Thompson-Junyang/ucf-hand-design-project/README.md

# UCF Robotic Hand Design Project

Written by Junyang. 

I created this repository as an **organized copy of the original ORCA Hand design files** for the UCF robotic hand project. So far, I have collected, reviewed, and sorted the files into a more convenient structure. **I have not yet redesigned the hardware.**

My next major objective is to **replace the original ORCA Hand actuators with Dynamixel AX-18A servos**. The AX-18A conversion is **planned, not implemented yet**; the current models should not be assumed to fit AX-18A motors.

## Official ORCA Hand resources

- **Official website:** [ORCA Hand](https://www.orcahand.com/)
- **Fabrication and assembly tutorial:** [ORCA Hand full fabrication and assembly tutorial](https://youtu.be/TgIz7HiyaoU?si=PWOCt1g08h2LHRF3)

## Where to start

1. Open [`all files we corrently need/orca_v2/base_basic v2 version start with this folder/`](all%20files%20we%20corrently%20need/orca_v2/base_basic%20v2%20version%20start%20with%20this%20folder/).
2. Start with `Prints-1100_the hand 3d designed files.3mf` for the hand print plates and `SiliconeMolds-1100_the mold 3d file for silicon skin.3mf` for the silicone-skin molds.
3. For individual STL and STEP components, open `full v2 hand files/` inside the same directory.
4. Read `full v2 hand files/ASSEMBLY_ADDENDUM.md` alongside the [ORCA Hand fabrication and assembly tutorial](https://youtu.be/TgIz7HiyaoU?si=PWOCt1g08h2LHRF3). The addendum includes important corrections about PTFE tubes, thumb pins, carpal bearings, and spools. I have already organized the project BOM; see the final section for my completed reference workbook.
5. Treat the `touch` and `lite` directories as alternative designs, not as required components of the base build.

> **Important:** The current files include original Dynamixel and Feetech-specific parts. A filename containing `Dynamixel` does **not** establish compatibility with the AX-18A. Check dimensions, horn interface, fasteners, cable routing, torque, and power requirements before fabrication.

## Repository directory guide

The directory names below are reproduced **exactly as stored in this repository**, including their existing spelling, to make them easy to find.

### 1. `all files we corrently need/` — selected working files

This is the **working collection I selected and organized** for the project, containing the ORCA V2 designs I plan to study and modify.

- **`orca_v2/`** — selected V2 mechanical and electronic design files.
  - **`base_basic v2 version start with this folder/`** — **primary starting point** for the standard V2 hand. Contains two conveniently named `.3mf` print projects and the more complete `full v2 hand files/` directory.
    - **`full v2 hand files/`** — complete base-V2 hand component collection, including `Prints-1100.3mf`, `SiliconeMolds-1100.3mf`, left/right ZIP archives, assembly notes, and the folders below:
      - **`01_Fingers/`** — printable finger segments and thumb components (`.stl`); `step_files/` contains corresponding editable/importable CAD exchange models (`.step`).
      - **`02_Carpals/`** — palm/carpal structures, cores, gearing, and TPU carpal-skin components; `step_files/` contains available STEP models.
      - **`03_Wrist/`** — wrist structures, adapters, cable holders, and wrist gear, including separate original **Dynamixel** and **Feetech** configurations; `step_files/` contains STEP counterparts. **Relevant to the future AX-18A fit check.**
      - **`04_ForeArm/`** — forearm/tower structures, front/back shells, covers, fans, and mounting-related parts, with original motor-system-specific variants; `step_files/` contains available STEP models. **Likely a major AX-18A redesign area.**
      - **`05_Spools/`** — tendon-winding spool, ratchet, spool cover, and tensioner components, with STEP counterparts in `step_files/`. **Check mechanical coupling to replacement servos.**
      - **`06_CNC/`** — manufacturing models and PDF technical drawings for machined components, including the spool holder and Franka connector.
      - **`07_Molds/`** — mold STLs and `.3mf` projects for silicone skins, including compression molds and clips.
      - **`09_Skin/`** — finger and carpal skin STL geometry for flexible covers.
      - **`assembly-addendum/`** — photographs and diagrams referenced by `ASSEMBLY_ADDENDUM.md` (PTFE routing, bearings, pins, spool identification, and assembly tips).
      - **`ASSEMBLY_ADDENDUM.md`** — text instructions supplementing the original assembly video; review before assembly.
  - **`electronics_pcb files and random/`** — original ORCA motor-connector PCB documentation: `ORCA_Motor_Connectors_BOM.xls` and `ORCA_Motor_Connectors_Gerber/`.
    - **`ORCA_Motor_Connectors_Gerber/`** — PCB fabrication layers, drill files, and `How-to-order-PCB.txt`. **Connector compatibility must be rechecked for AX-18A.**
  - **`lite_a simple verson of v2 we dont need/`** — lightweight/simplified V2 variant files (`.stl`/`.step`). Retained for reference; **not the current build target**.
  - **`touch_the version that allows us to add touch sensor/`** — alternative V2 design intended to accommodate fingertip touch sensors. Contains `Prints-2100.3mf`, `SiliconeMolds-2100.3mf`, and left/right ZIP archives.
    - **`01_Fingers/`** — touch-variant finger STL parts; `step_files/` contains available STEP models.
    - **`02_Carpals/`** — touch-variant carpal STL parts; `step_files/` contains STEP models.
    - **`09_OldPrintBeds/`** — earlier touch-variant `.3mf` print-bed projects; use the main `Prints-2100.3mf` as the current touch starting point instead.

### 2. `full files check it out if have time/` — complete upstream reference archive

I kept this folder as a broader archive of original ORCA project material. It is **reference material**, not my preferred starting point for the UCF build.

- **`README.md`** — upstream ORCA file-set overview, including variants, print projects, and scripts.
- **`assets/`** — upstream documentation image assets (including `banner.png`).
- **`orca_v1/`** — older ORCA Hand V1 design, useful for historical comparison:
  - **`ORCA_Assembly/`** — V1 assembly STEP model.
  - **`ORCA_Electronics/`** — V1 motor-connector BOM and `ORCA_Motor_Connectors_Gerber/` fabrication files.
  - **`ORCA_Fingers/`** — V1 finger geometry.
  - **`ORCA_Misc/`** — miscellaneous parts, including a camera mount.
  - **`ORCA_Molds/`** — V1 finger and palm skin mold models.
  - **`ORCA_Spools/`** — V1 tendon spool, ratchet, holder, and tensioning components.
  - **`ORCA_Tower/`** — V1 tower/actuator mounting, gearing, carpal, and support parts.
  - **`Print_Files_Bambu/`** — V1 Bambu Studio `.3mf` print projects for fingers, wrist, molds, spools, and tower.
- **`orca_v2/`** — original V2 source collection:
  - **`base/`** — original base V2 hand: the same component categories as the selected `full v2 hand files/` directory (`01_Fingers`, `02_Carpals`, `03_Wrist`, `04_ForeArm`, `05_Spools`, `06_CNC`, `07_Molds`, `09_Skin`, and `assembly-addendum`), plus base print projects, ZIP archives, and `ASSEMBLY_ADDENDUM.md`.
  - **`electronics/`** — original motor-connector BOM and `ORCA_Motor_Connectors_Gerber/` PCB fabrication files.
  - **`lite/`** — original simplified V2 part collection.
  - **`touch/`** — original touch-sensor V2 variant, including `01_Fingers/`, `02_Carpals/`, `09_OldPrintBeds/`, touch print/mold `.3mf` projects, and ZIP archives.
- **`scripts/`** — upstream Python utilities for managing `.3mf` projects:
  - `find_3mf_for_file.py` — identify which print projects contain a particular STL.
  - `update_3mf.py` — update or inspect STL references inside a `.3mf` project.
  - `update-print-files.py` — automate print-project updates from changed files.
  - `dedup_3mf.py` and `dedup_3mf_build_items.py` — utilities related to removing duplicate `.3mf` data/build items.
- **`package.json` / `package-lock.json`** — upstream package metadata and dependency lockfile; not necessary merely to open STL/STEP/3MF files.

## File formats

| Format | Purpose |
|---|---|
| `.3mf` | Pre-arranged 3D printing projects; open in a compatible slicer such as Bambu Studio. |
| `.stl` | Mesh geometry for printing and inspection. |
| `.step` | CAD exchange geometry useful for modifying mechanical designs. |
| `.zip` | Packaged original design files. |
| `.pdf` | Technical drawings and manufacturing documentation. |
| `.xls` | Original motor-connector PCB bill of materials. |
| Gerber / `.DRL` | PCB fabrication layers and drill data. |
| `.md` | Markdown documentation. |

## Planned development: Dynamixel AX-18A conversion

**Status: not started / not yet implemented in the stored design files.** My planned engineering sequence is:

1. **Document the baseline:** identify the original motor models, number of actuators, mounting points, tendon routing, and electrical interfaces.
2. **Check AX-18A mechanical compatibility:** body envelope, horn/output geometry, mounting-hole spacing, clearances, and service access.
3. **Redesign mounts and support structures:** prioritize the forearm/tower, wrist interface, and any actuator brackets that require modification.
4. **Review tendon transmission:** check spool geometry, horn coupling, cable travel, winding direction, friction, and tensioning.
5. **Review electrical and control interfaces:** verify power distribution, connectors, communication protocol, controller support, and actuator limits.
6. **Produce revised CAD and print files:** maintain a separate AX-18A design revision rather than overwriting original ORCA reference models.
7. **Prototype, assemble, and validate:** check mechanical fit, range of motion, tendon tension, repeatability, and thermal/electrical behavior.

Do not print or purchase AX-18A-specific hardware based solely on the current original motor-holder files; the conversion needs its own validated design.

## Fabrication Process

This section records my fabrication progress for the ORCA Hand V2 build. I will update each stage as the work progresses.

### 1. 3D Printing — Tested Print Project

**Status as of October 23, 2026: Print settings tested and stable.**

I am currently printing the latest **ORCA Hand V2 V1100** version. The `.3mf` project files I uploaded to this repository are **my optimized printing projects**, rather than unmodified upstream print settings. I prepared and tested these projects for the **Bambu X2D** printer.

- **Design revision:** ORCA Hand V2, V1100.
- **Printer:** Bambu X2D.
- **Primary printing material:** PLA.
- **Support material:** PETG (support interface/material).
- **Print profile:** My tested and stable parameter configuration, saved in the uploaded `.3mf` projects.
- **Working project files:** `all files we corrently need/orca_v2/base_basic v2 version start with this folder/`, including `Prints-1100_the hand 3d designed files.3mf` and `SiliconeMolds-1100_the mold 3d file for silicon skin.3mf`.

The uploaded `.3mf` files should be used when reproducing my tested print setup. The print profile has been tested for stability.

#### 3D Printing Examples

The following images document my actual V1100 printing process using the tested `.3mf` projects. They show the different groups of components being printed, including the silicone-skin molds.

**1. Finger components — printing process**

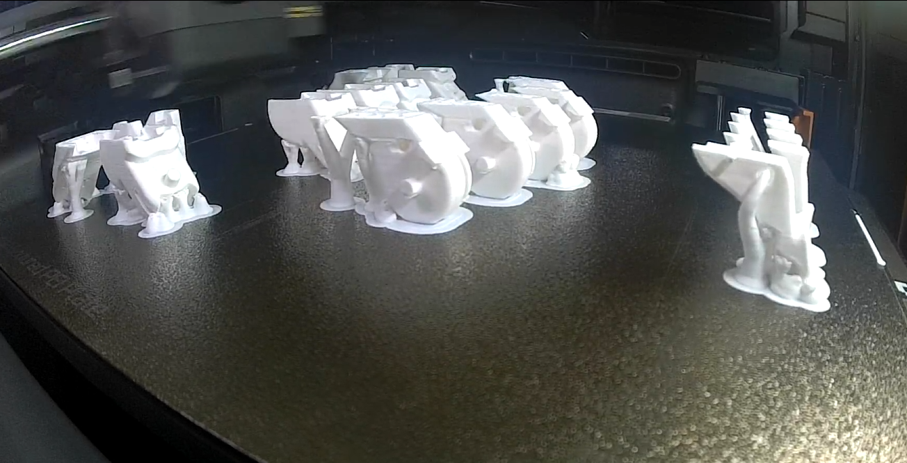
[picture p1: fabrication_images/01_finger_printing.png]
ORCA Hand V1100 finger components being printed


**2. Wrist components — printing process**

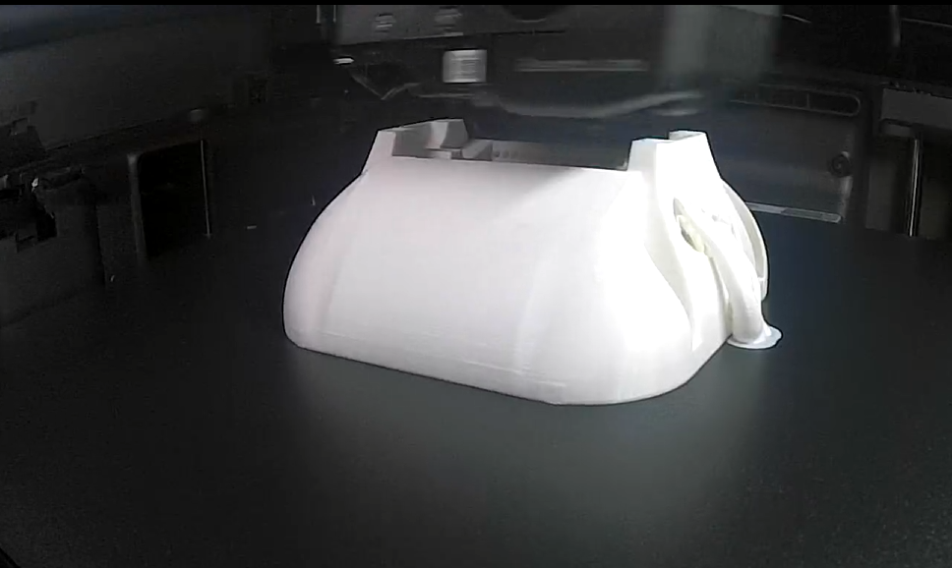
[picture p2: fabrication_images/02_wrist_printing.png]
ORCA Hand V1100 wrist component being printed


**3. Forearm structure and motor-mount section — printing process**

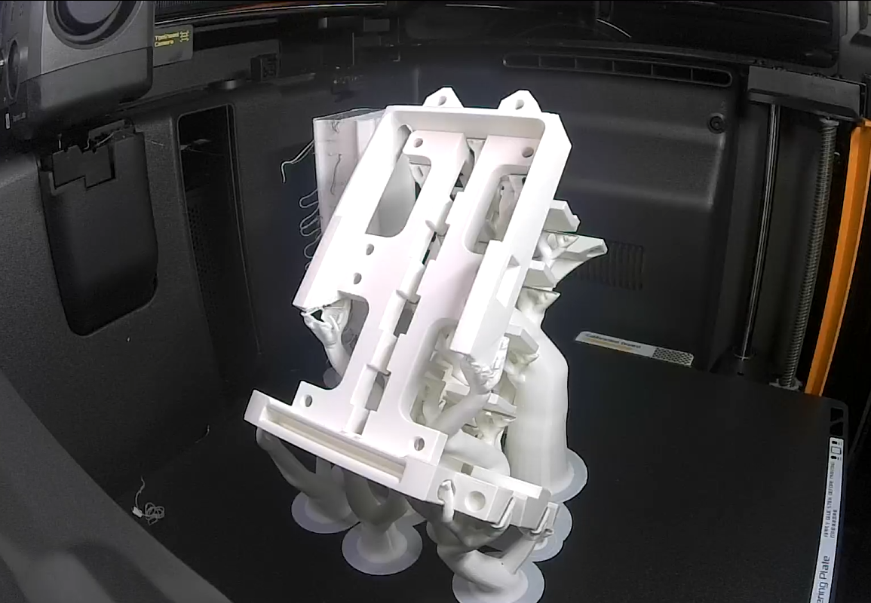
[picture p3: fabrication_images/03_forearm_motor_mount_printing.png]
ORCA Hand V1100 forearm structure including the original motor-mount section being printed


**4. Silicone-skin molds — 3D printing process**

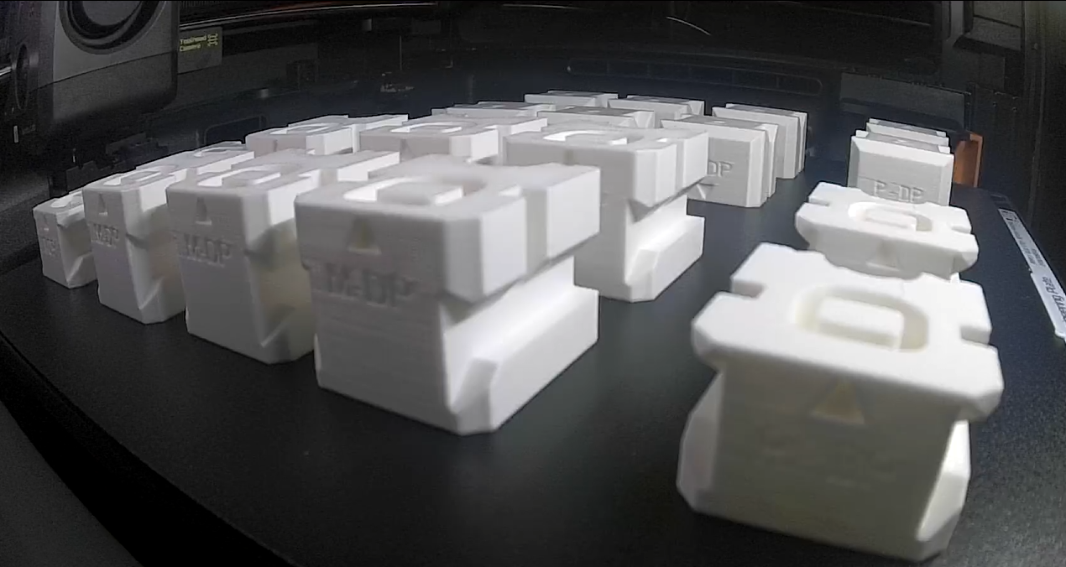
[picture p4: fabrication_images/04_silicone_skin_mold_printing.png]
ORCA Hand V1100 silicone-skin molds being printed


These images document 3D printing only. Printing the silicone molds does not mean silicone casting has been completed, and printing the original motor-mount structure does not mean the planned AX-18A modification has been implemented.

### November 2, 2026 — Multi-Material Support Printing (PLA/PETG)

**Status: Support-interface printing method researched and applied to ORCA Hand V1100 slicing layouts.**

I investigated using **PLA and PETG as dissimilar support materials** to improve the surface finish of supported regions in FDM printing. PLA and PETG generally adhere poorly to each other under suitable printing conditions. This makes it possible to use **PLA as the support interface for PETG parts**, or **PETG as the support interface for PLA parts**, so the support can separate more easily from the printed model.

In conventional same-material supports, a gap is often required between the support and the model to allow removal, which can leave rough undersides. With a properly tuned dissimilar-material interface, the support can be placed closer to the model, potentially producing **smoother supported surfaces and cleaner overhangs** while reducing support-removal damage. This is especially useful for the complex geometries and overhangs in the ORCA Hand parts. Print temperature, purge/flush volume, interface spacing, and material compatibility still require appropriate slicer settings and validation.

#### Reference Examples — Multi-Material Support Method

The first four images are explanatory references attributed to Bambu Lab and Prusa, illustrating dissimilar-material support and the distinction between the support base and the support interface. They are **reference illustrations, not photographs of my own prints**.

**1. Surface-finish comparison — PETG with PLA support vs. PETG support**

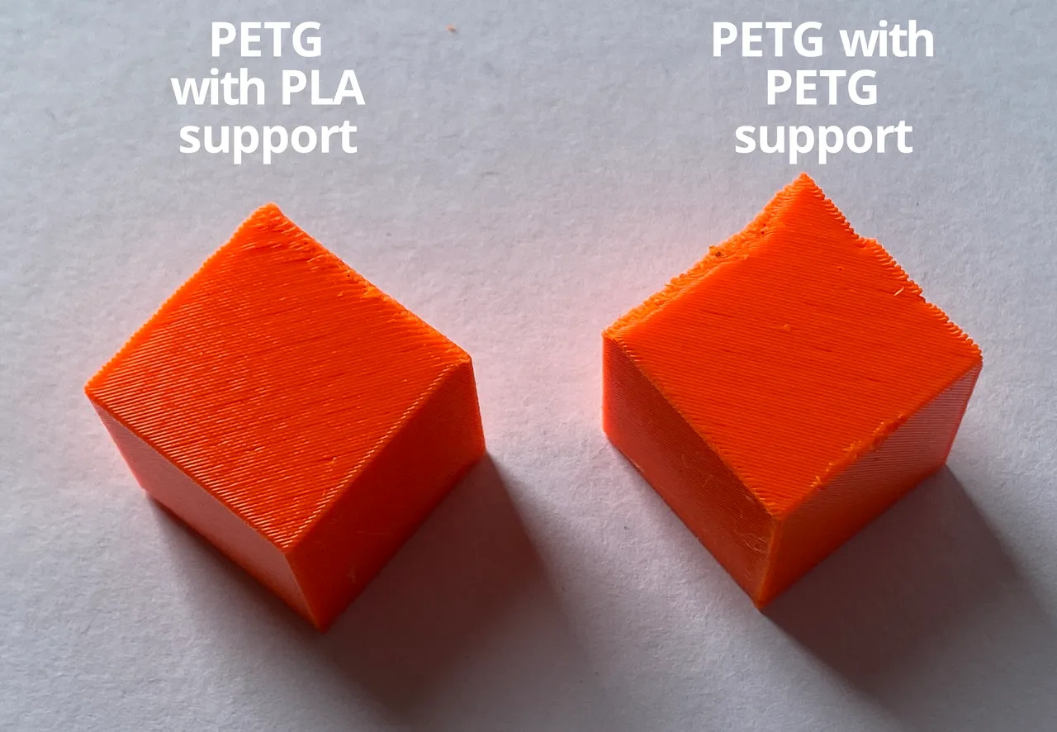
[picture p5: fabrication_images/11_support_reference_surface_comparison.png]
Reference comparison of PETG printed with PLA support and PETG support


**2. Material arrangement — PLA model and PETG support interface**

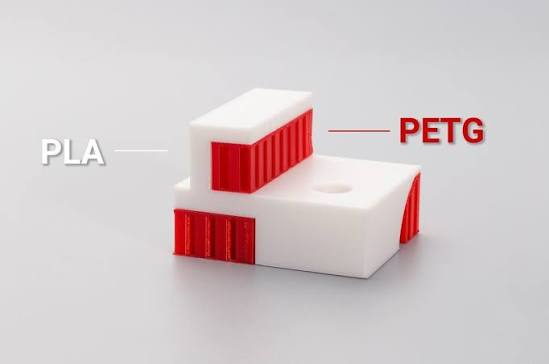
[picture p6: fabrication_images/12_support_reference_material_arrangement.png]
Reference diagram illustrating PLA and PETG support materials


**3. Support-removal example — dissimilar-material and same-material supports**

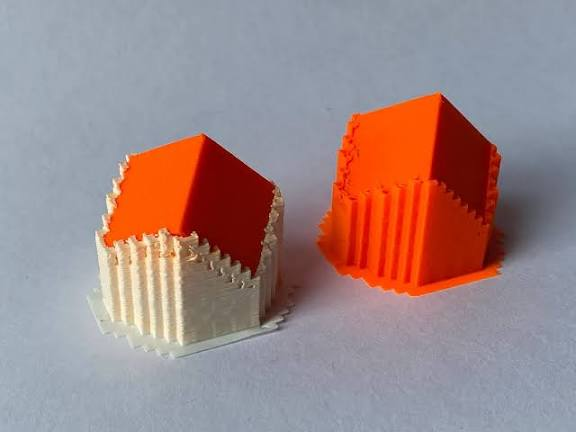
[picture p7: fabrication_images/13_support_reference_removal_comparison.png]
Reference example comparing support removal


**4. Support interface versus support base**

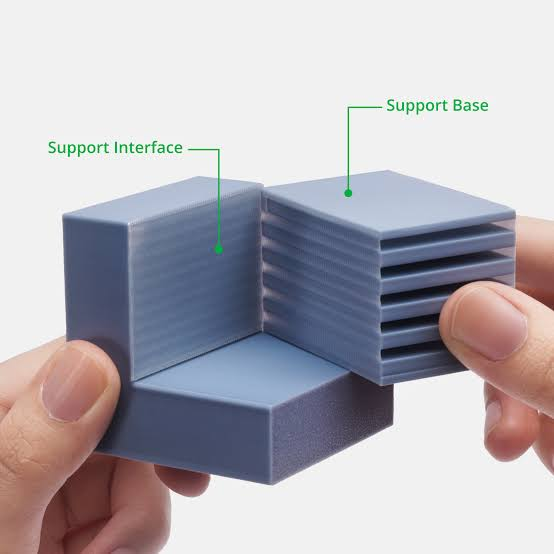
[picture p8: fabrication_images/14_support_reference_interface_base.png]
Reference illustration labeling support interface and support base


#### Application to the ORCA Hand V1100 Print Project

I applied the dissimilar-material support approach to the ORCA Hand print layout in the slicer. The following screenshots show the hand components, their complex overhangs, and the configured support structures. These screenshots document the **slicing setup and implementation**, rather than a measured comparison of finished printed surfaces.

**5. ORCA Hand slicing layout — multi-material support configuration (view 1)**

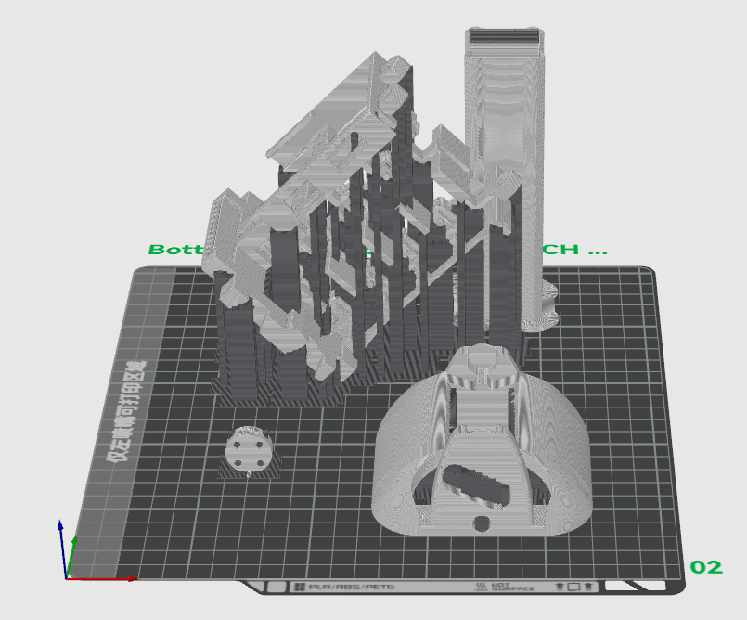
[picture p9: fabrication_images/15_orca_multimaterial_support_slicer_view1.png]
ORCA Hand V1100 slicing layout with support structures, view 1


**6. ORCA Hand slicing layout — multi-material support configuration (view 2)**

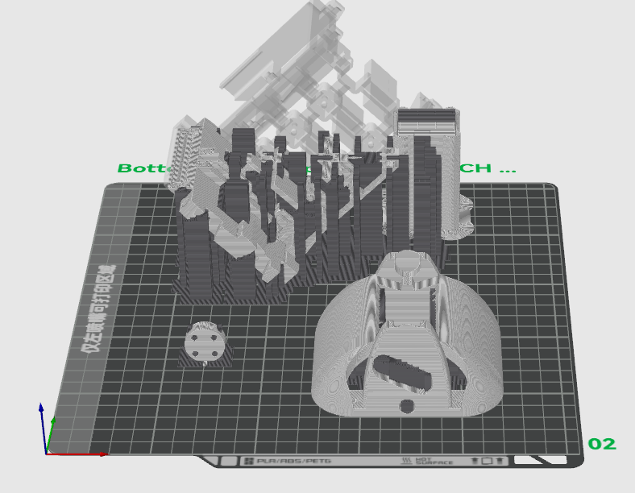
[picture p10: fabrication_images/16_orca_multimaterial_support_slicer_view2.png]
ORCA Hand V1100 slicing layout with support structures, view 2


**Next verification:** Print and inspect the supported surfaces on the actual ORCA Hand parts to compare removal quality and surface finish with the previous support setup.

### 2. Silicone Molding — Initial Casting and Demolding

**Status as of October 23, 2026: Initial silicone molding and demolding completed; process documentation ongoing.**

I have started fabricating the silicone skins using the 3D-printed V1100 molds. The photos below document my initial casting, demolding, and organization work. I used a two-part silicone system (Parts A and B 1: 1). The curing condition is room temp over 10 hours.

#### Silicone Molding Examples

**1. Silicone casting — mold filling process**

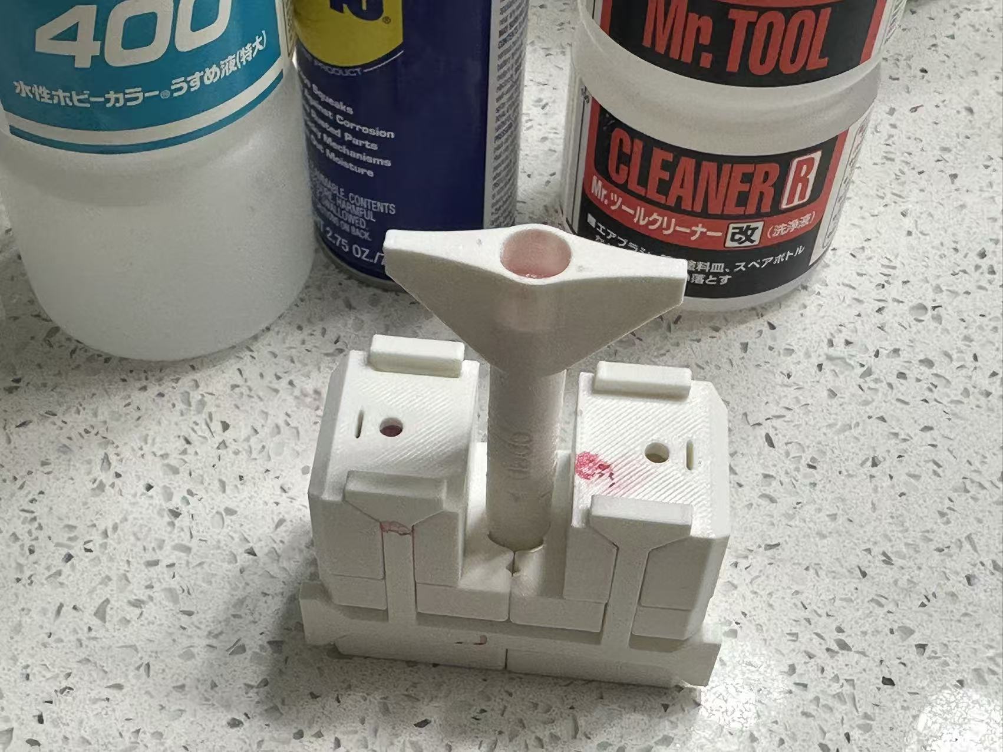
[picture p11: fabrication_images/05_silicone_casting.jpg]
Silicone being cast into a 3D-printed mold


**2. Demolding — removing the silicone skin from the mold**

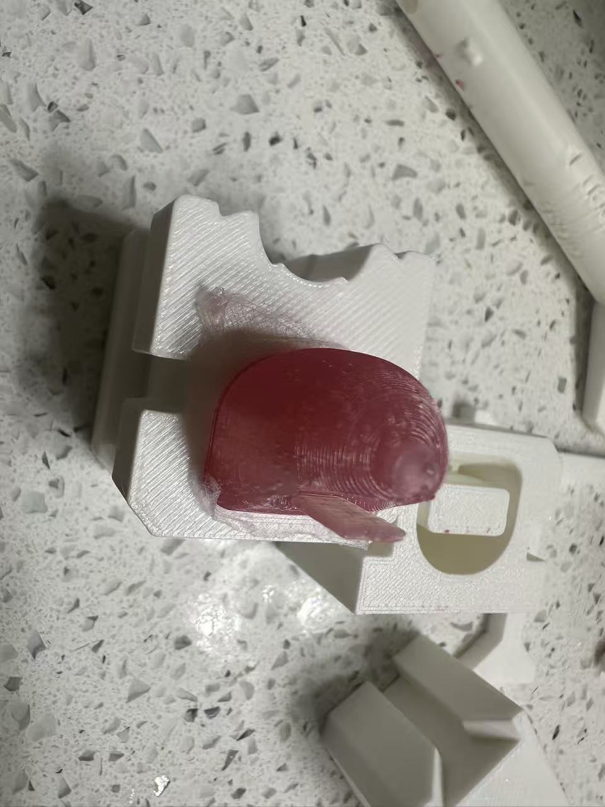
[picture p12: fabrication_images/06_silicone_demolding.jpg]
A pink silicone skin being removed from a 3D-printed mold


**3. Demolded silicone skins — sorting the finished pieces**

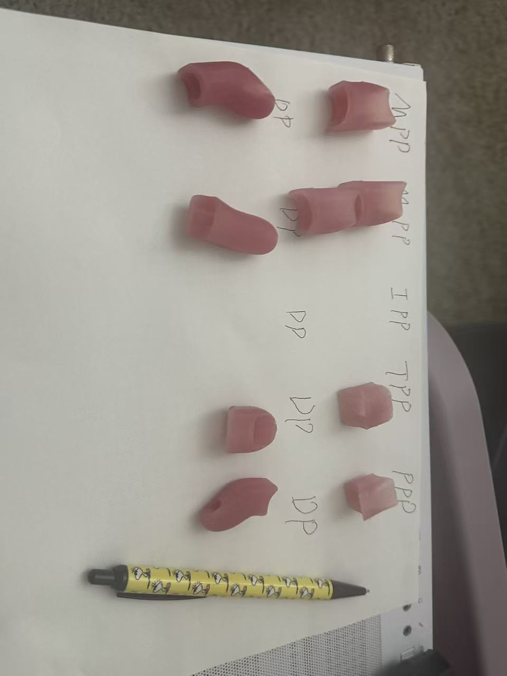
[picture p13: fabrication_images/07_demolded_silicone_skins.jpg]
Demolded pink silicone finger skins organized by part


**4. Mold organization — storing the 3D-printed molds**

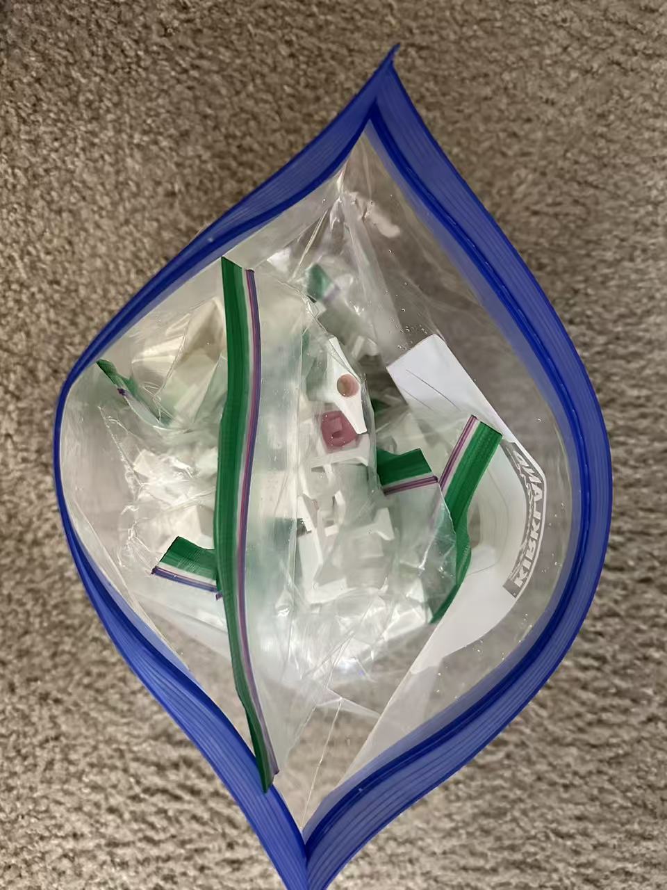
[picture p14: fabrication_images/08_molds_storage.jpg]
3D-printed silicone molds organized in labeled storage bags


**5. Silicone raw materials — two-part A/B silicone**

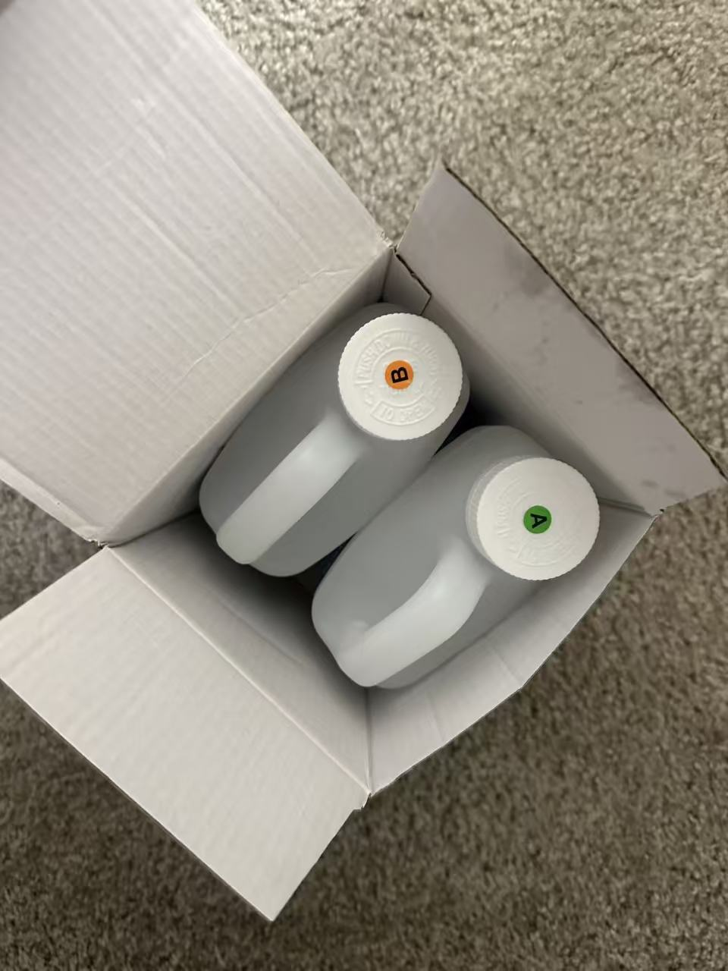
[picture p15: fabrication_images/09_silicone_materials_ab.jpg]
Containers of the two-part silicone materials labeled A and B


These photos show that I have carried out initial silicone casting and demolding. They establish the complete set of skins.

### 3. Mechanical Assembly

**Status as of October 23, 2026: Initial finger assembly documented; additional assembly work ongoing.**

This stage will record the physical assembly of the printed components and hardware, including bearings, pins, tendon routing, PTFE tubing, spools, and silicone skins. I will refer to the official fabrication video and `ASSEMBLY_ADDENDUM.md` while documenting the actual assembly steps and any corrections needed.

#### Step 1. Finger Assembly

I have completed the initial assembly of the finger components, fitting the molded silicone skins onto the printed articulated finger sections. The photo shows the assembled fingers with their tendon lines extending from the base. This documents the finger assembly stage; the complete hand and motor integration are not yet finished.

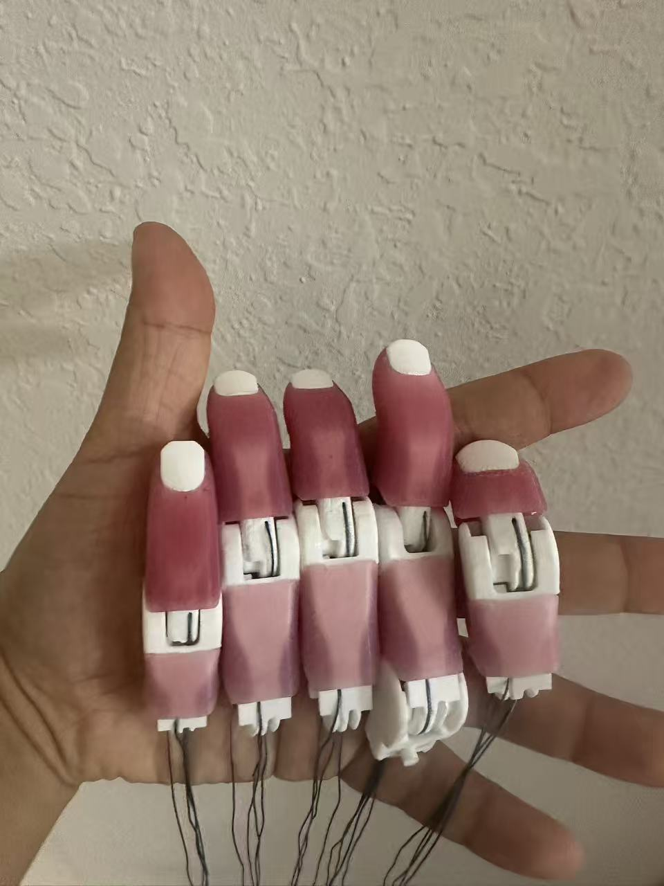
[picture p16: fabrication_images/10_finger_assembly.jpg]
Initial ORCA Hand V1100 finger assembly with silicone skins and tendon lines


### 4. Mechanical Modifications

**Status as of October 23, 2026: Not started.**

The planned mechanical changes include adapting the original ORCA Hand structure for Dynamixel AX-18A servos. I have not yet completed any modified CAD, motor mounts, or revised transmission components.

### 5. Motor Integration

**Status as of October 23, 2026: Not started.**

This stage will cover installing and connecting the AX-18A motors, including mechanical mounting, power distribution, communication wiring, and initial actuator tests. No AX-18A motor integration has been completed yet.

### 6. Embedded Programming

This stage documents firmware and control development for the motors and hand, including communication, actuator commands, calibration, and motion testing.

#### OpenCR Controller and Arduino IDE Setup (Windows)

I am using the **ROBOTIS OpenCR board** as the embedded development controller for the AX-18A motor tests. The board provides USB connectivity for programming and serial debugging, DYNAMIXEL communication interfaces, and additional I/O for future development.

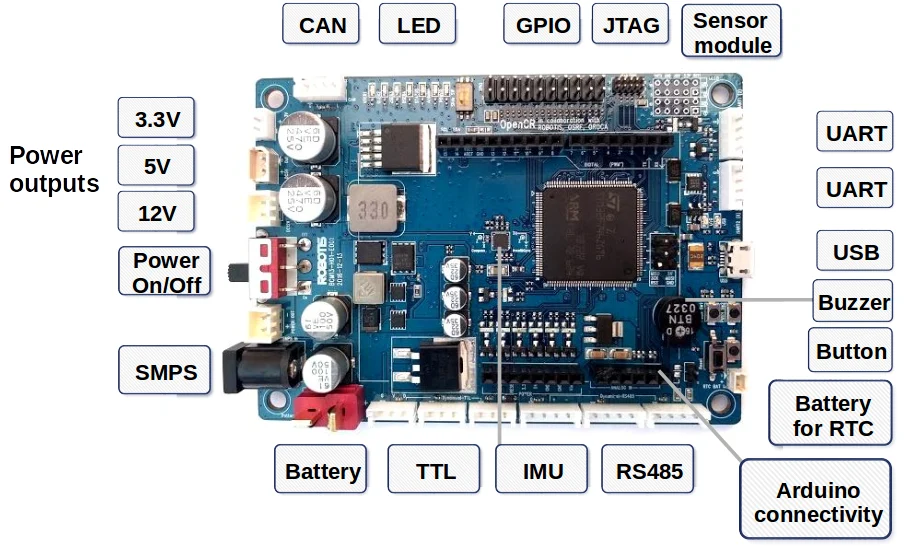
[picture p17: fabrication_images/18_opencr_board_overview.png]
ROBOTIS OpenCR board interface and connector overview


**Arduino IDE and OpenCR board installation**

1. Download and install the [Arduino IDE](https://www.arduino.cc/en/software) on Windows. The original OpenCR installation guide specifies Arduino IDE version 1.6.4 or later.
2. In Arduino IDE, open **File → Preferences** and add the following URL under **Additional Boards Manager URLs**:

   ```text
   https://raw.githubusercontent.com/ROBOTIS-GIT/OpenCR/master/arduino/opencr_release/package_opencr_index.json
   ```

3. Open **Tools → Board → Boards Manager**, search for **OpenCR**, and install the **OpenCR by ROBOTIS** board package. The package download and installation may take some time.
4. Select the **OpenCR Board** from **Tools → Board**.
5. Connect the OpenCR board to the PC using USB. Under **Tools → Port**, select the COM port assigned to the connected board (the example `COM1` in some instructions is not a universal port number).
6. Select the board and port before uploading sketches, and use the serial monitor for debugging when needed.

**USB driver note:** The original installation instructions mention an ST USB CDC driver for **Windows versions earlier than 8.x**. That legacy requirement should not be assumed necessary on modern Windows systems. The referenced ST driver page is [STSW-STM32102](https://www.st.com/en/development-tools/stsw-stm32102.html).

**OpenCR software reference:** [ROBOTIS OpenCR Arduino source and board package](https://github.com/ROBOTIS-GIT/OpenCR).

### November 3, 2026 — Embedded Programming Progress: AX-18A Motor Control

**Status: Initial embedded motor-control programs developed; actuator communication and position-control testing in progress.**

I began developing and organizing embedded test programs for the planned Dynamixel AX-18A conversion. The current experiments use an **OpenCR controller**, the **Dynamixel2Arduino** library, and **DYNAMIXEL Protocol 1.0**, which is required by the AX-18A.

My work includes:

- Setting up communication between the PC, OpenCR, and AX-18A through the appropriate serial interfaces.
- Configuring motor communication at **1 Mbps**, including motor detection using `ping()`.
- Developing test utilities for motor ID and baud-rate configuration.
- Testing torque enable/disable and position-control commands.
- Adding a wrist-motion test program that repeatedly commands a single actuator between two target positions (**RAW 380** and **RAW 40**) with a **500 ms** pause after each command.
- Using serial debug messages to inspect setup results and command transmission.

#### Embedded Control Demonstration

The following GIF documents a hands-on demonstration associated with the current robotic-hand control work. It provides a visual progress record; it is not a quantitative validation of accuracy, load capacity, or full-hand integration.

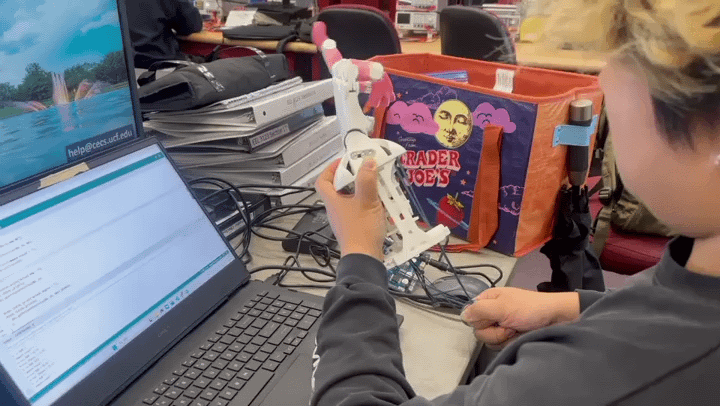
[picture p18: fabrication_images/17_ax18a_embedded_control_demo.gif]
ORCA Hand embedded motor-control demonstration, November 3, 2026


#### Current Test Code

- `current_Motor_test_codes/wrist_loop_back_forward/wrist_loop_back_forward.ino` — repeated position-command test for a single AX-18A actuator.
- Additional motor test sketches in `current_Motor_test_codes/` — communication and configuration experiments, including ID and baud-rate changes.

**Next steps:** Verify repeatability and actual position feedback under motion, establish safe motion limits, and integrate the tested control approach with the redesigned hand hardware. The current tests do **not** establish that all AX-18A actuators have been mechanically installed or that the full hand is under coordinated motor control.

## BOM — Organized by Junyang (Completed)

> [!WARNING]
> **Do not use the original ORCA Hand README or official BOM as the purchasing authority for this project.** While organizing the BOM, I identified **multiple errors, omissions, and inconsistencies** in the official documentation. Some quantities, dimensions, and hardware revisions do not agree with the updated assembly instructions. The official files remain useful as design references, but **do not order components directly from their lists without checking my organized BOM and the actual CAD/assembly revision**.

**BOM organized by me (Junyang):** [`ORCA_Hand_V2_Complete_BOM_Organized_by_Junyang.xlsx`](ORCA_Hand_V2_Complete_BOM_Organized_by_Junyang.xlsx) — the component and procurement workbook I have already collected, checked, and organized for this project (October 2026). **The BOM organization task is complete; I do not need other team members to review or reorganize it at this stage.** I will handle any remaining technical verification marked `VERIFY`, `VERIFY CAD`, or similar before ordering.

### BOM reference notes

1. **Build scope:** quantities are for **one hand (left or right)**. The original build uses **one** motor configuration (`Dynamixel DX` **or** `Feetech FT`), not both.
2. **Quantities:** `Assembly Qty` is the installed quantity; `Spare Qty` is the extra allowance; `Purchase Qty` includes listed spares. Units are indicated in the notes (for example, tendon length is in meters).
3. **Status:** `Confirmed` reflects the current BOM review, **not a guarantee that the item has been physically test-fitted**. `VERIFY`, `VERIFY CAD`, and other qualifications are flagged for my follow-up before ordering.
4. **Known conflicts:** the two wrist-bearing options (`6×13×5 mm` original and `8×13×4 mm` addendum) are **alternatives**. I will verify the selected CAD/revision; **both should not be purchased by default**. The addendum also introduces `Ø3×50 mm` carpal wrist pins and `Ø2×30 mm` thumb AP pins.
5. **PTFE and print revisions:** several PTFE diameters/lengths remain to be verified; the finger AP tube count assumes five AP parts. V1100 spools have **four** screw holes, whereas V1000 spools have **five**. I will match parts to the correct print revision.
6. **Optional hardware:** Franka interface components can be omitted if the hand uses another mounting arrangement.
7. **Pricing:** supplier, unit price, and extended-cost fields are intentionally available for procurement planning; blanks are **not** zero-cost items.

### Original actuator reference — not the AX-18A redesign

| Original configuration | Wrist actuator | Finger actuators |
|---|---|---|
| Dynamixel DX | `XC430-T240BB-T` × 1 | `XC330-T288-T` × 16 |
| Feetech FT | `HL-3930-Plastic` × 1 | `HL-2915-Plastic` × 16 |

These are **baseline reference configurations**, not motors I intend to purchase automatically. My intended **AX-18A conversion is future work**. I will re-evaluate the original motor counts and power/control parts for the redesigned system; the current workbook is **not yet an AX-18A-specific BOM**.

**Related resources:** [ORCA Hand official site](https://www.orcahand.com/) · [Full fabrication and assembly tutorial](https://youtu.be/TgIz7HiyaoU?si=PWOCt1g08h2LHRF3) · [`ASSEMBLY_ADDENDUM.md`](all%20files%20we%20corrently%20need/orca_v2/base_basic%20v2%20version%20start%20with%20this%20folder/full%20v2%20hand%20files/ASSEMBLY_ADDENDUM.md)

## Credits and licensing

Original ORCA Hand project and design credit belongs to its respective creators and contributors. I have organized a copy of these files for UCF project development; I do not claim authorship of the original ORCA designs.

- [Official ORCA Hand website](https://www.orcahand.com/)
- [ORCA Hand hardware project](https://github.com/orcahand/orcahand_hardware)
- [Original ORCA files](https://github.com/orcahand/orca_files)
- [ORCA Hand fabrication and assembly tutorial](https://youtu.be/TgIz7HiyaoU?si=PWOCt1g08h2LHRF3)

**License note:** This repository currently has a root `LICENSE` file, while the archived upstream README identifies the ORCA design files as **CC BY 4.0**. Retaining original attribution and applicable upstream licensing is important; the presence of a root license does not automatically supersede the license of copied upstream material.

---
