Thompson-Junyang/ucf-hand-design-project/ORCA_Hand_V2_Complete_BOM_Organized_by_Junyang.xlsx

Sheet: Common Hardware
Category | Component | Specification | Assembly Qty | Spare Qty | Notes / Location | Status | Purchase Qty | Unit Price (USD) | Extended Cost (USD) | Supplier / Link
Bearings | Miniature bearing | 4x8x3 mm MR84 | 55 | 4 | WristAdapter, TopSpool, fingers | Confirmed | 59
Bearings | Wrist bearing (original) | 6x13x5 mm | 2 | 0 | Alternative to addendum; do not purchase both | VERIFY CAD | 2
Bearings | Wrist bearing (addendum) | 8x13x4 mm | 2 | 0 | Alternative to original; do not purchase both | VERIFY CAD | 2
Pins | Cylindrical pin | Ø4x10 mm | 1 | 0 | Wrist | Confirmed | 1
Pins | Dowel pin | Ø2x10 mm | 2 | 0 | Thumb AP | Confirmed | 2
Pins | Dowel pin | Ø2x8 mm | 13 | 0 | AP and PP | Confirmed | 13
Pins | Dowel pin | Ø2x6 mm | 12 | 0 | PP | Confirmed | 12
Pins | Dowel pin | Ø3x50 mm | 2 | 0 | Carpals wrist joint; Ø3x45 barely fits | Addendum | 2
Pins | Dowel pin | Ø2x30 mm | 2 | 0 | Updated thumb AP | Addendum | 2
Hardware | Magnet | Ø3x5 mm | 16 | 0 | Hulls | Confirmed | 16
Hardware | M4 washer | M4 | 2 | 1 | Wrist | Confirmed | 3
Hardware | M4 square nut | M4 | 2 | 1 | Wrist | Confirmed | 3
Hardware | M4 hex nut | M4 | 3 | 0 | TopTower | Confirmed | 3
Hardware | M3 nut | M3 | 20 | 2 | Fans, board, connectors, holders | Confirmed | 22
Hardware | M2 nut | M2 | 16 | 4 | BottomSpools | Confirmed | 20
Screws | Socket head screw DIN 912 | M4x20 | 2 | 0 | Wrist | Confirmed | 2
Screws | Socket head screw DIN 912 | M4x10 | 6 | 2 | TopTower and top/bottom connection | Confirmed | 8
Screws | Socket head screw DIN 912 | M3x14 | 6 | 2 | Fans | Confirmed | 8
Screws | Socket head screw DIN 912 | M3x12 | 14 | 0 | Spool holders, fans, Franka | Confirmed | 14
Screws | Socket head screw DIN 912 | M3x8 | 2 | 2 | Top/bottom connection | Confirmed | 4
Screws | Socket head screw DIN 912 | M3x6 | 2 | 1 | Board | Confirmed | 3
Screws | Socket head screw DIN 912 | M2x8 | 20 | 2 | Spools and WristSpool | Confirmed | 22
Screws | Socket head screw DIN 912 | M2x4 | 64 | 6 | Spools | Confirmed | 70

Sheet: Tendons and PTFE
Category | Component | Specification | Assembly Qty | Spare Qty | Notes / Location | Status | Purchase Qty | Unit Price (USD) | Extended Cost (USD) | Supplier / Link
Transmission | UHMWPE braided fishing line | Ø0.39 mm, ~67 kg strength | 24 | 6 | Quantity unit: meters | Confirmed | 30
Transmission | GT2 timing belt | 142 mm long, 6 mm wide | 1 | 0 | Wrist | Confirmed | 1
PTFE | Flexible PTFE tubing | Ø4 mm, 20 mm length | 2 | 0 | Wrist M4 screws | Confirmed | 2
PTFE | Finger AP tubing | Diameter TBD, 8–10 mm segments | 10 | 0 | 2 per AP; assumes 5 AP parts | VERIFY | 10
PTFE | Carpals tubing | Diameter/length TBD | 32 | 0 | One per channel; trim 1 mm proud | Addendum | 32
PTFE | Tower tubing | Diameter/length TBD | 32 | 0 | One per channel; trim 1 mm proud | Addendum | 32

Sheet: Printed and Silicone
Category | Component | Specification | Assembly Qty | Spare Qty | Notes / Location | Status | Purchase Qty | Unit Price (USD) | Extended Cost (USD) | Supplier / Link
3D print | All printed plates | Left or right; DX/FT and revision matched | 1 | 0 | One complete set; individual STL counts TBD | VERIFY | 1
3D print | Silicone casting molds | PLA, matched to selected hand | 1 | 0 | One mold set; print quantities TBD | VERIFY | 1
Material | PLA filament | eSUN PLA |  |  | Amount TBD by slicer | VERIFY
Material | Silicone | Dragon Skin 10 NV |  |  | Amount TBD by mold volume | VERIFY
Silicone skin | Carpals skin | Black | 1 | 0 | Palm | Confirmed | 1
Silicone skin | Middle finger skin | White | 3 | 0 | Fingers | Confirmed | 3
Silicone skin | Thumb skin | White | 1 | 0 | Thumb | Confirmed | 1
Silicone skin | Pinky skin | White | 1 | 0 | Pinky | Confirmed | 1

Sheet: Franka Interface
Category | Component | Specification | Assembly Qty | Spare Qty | Notes / Location | Status | Purchase Qty | Unit Price (USD) | Extended Cost (USD) | Supplier / Link
Mount | CNC robot arm connector plate | Franka connector | 1 | 0 | Optional if not using Franka | Optional | 1
Screws | Low-profile screw | M6x8 DIN 912 per original BOM | 4 | 0 | Franka connector | VERIFY head geometry | 4
Mount | Threaded rod | M5x100 mm | 2 | 0 | Franka connector | Optional | 2

Sheet: Dynamixel DX
Category | Component | Specification | Assembly Qty | Spare Qty | Notes / Location | Status | Purchase Qty | Unit Price (USD) | Extended Cost (USD) | Supplier / Link
Motor | Wrist actuator | XC430-T240BB-T | 1 | 0 | Wrist | Confirmed | 1
Motor | Finger actuator | XC330-T288-T | 16 | 0 | Fingers | Confirmed | 16
Electronics | Dynamixel PowerBoard | Official board | 1 | 0 | Power distribution | Confirmed | 1
Electronics | U2D2 | ROBOTIS USB converter | 1 | 0 | USB communication | Confirmed | 1
Electronics | Motor connector PCB | Official PCB |  |  | Exact number TBD | VERIFY
Cooling | Fan | 50x50x10 mm; 90 mm cable | 2 | 0 | Tower | Confirmed | 2
Power | AC adapter | 12 V 5 A | 1 | 0 | Hand power | Confirmed | 1
Connectivity | USB-C cable | PC to orca_core | 1 | 0 | Common item; count once | Confirmed | 1
Screws | Socket head screw DIN 912 | M2x8 | 4 | 0 | Additional DX wrist screws | Confirmed | 4
Cable | 3XP JST EH 2.5mm EHR-3 | 180 mm, board to servo | 1 | 2 | Custom | Confirmed | 3
Cable | 3XP JST EH 2.5mm EHR-3 | 100 mm, daisy chain | 4 | 2 | Servo chaining | Confirmed | 6

Sheet: Feetech FT
Category | Component | Specification | Assembly Qty | Spare Qty | Notes / Location | Status | Purchase Qty | Unit Price (USD) | Extended Cost (USD) | Supplier / Link
Motor | Wrist actuator | HL-3930-Plastic | 1 | 0 | Wrist | Confirmed | 1
Motor | Finger actuator | HL-2915-Plastic | 16 | 0 | Fingers | Confirmed | 16
Electronics | FE-URT-2 | USB-C control board | 1 | 0 | Motor communication | Confirmed | 1
Cooling | Fan | 50x50x10 mm; 70 mm cable | 2 | 0 | Tower | Confirmed | 2
Power | AC adapter | 12 V 5 A | 1 | 0 | Hand power | Confirmed | 1
Connectivity | USB-C cable | PC to orca_core | 1 | 0 | Common item; count once | Confirmed | 1
Screws | Socket head screw DIN 912 | M3x6 | 1 | 0 | Additional FT wrist screw | Confirmed | 1
Screws | Socket head screw DIN 912 | M3x8 | 4 | 0 | Additional FT wrist screws | Confirmed | 4
Cable | 3XP 2.5mm to 1.25mm | 160 mm | 2 | 2 | Board to servo | Confirmed | 4
Cable | 3XP 1.25mm to 1.25mm | 100 mm | 3 | 2 | Finger daisy chain | Confirmed | 5
Cable | 3XP 2.5mm to 1.25mm | 100 mm | 1 | 2 | Finger to wrist | Confirmed | 3
Cable | 3XP 1.25mm to 1.25mm | 50 mm | 12 | 4 | Finger daisy chain | Confirmed | 16

Sheet: Read Me
ORCA Hand V2 — Complete BOM | October 2026
One hand (left or right); select ONE motor variant (DX or FT).
Assembly Qty excludes spare parts. Purchase Qty includes listed spares.
The two wrist-bearing rows are ALTERNATIVES; do not buy both before checking CAD.
PTFE tubing dimensions and total length require CAD verification.
The AP tubing count assumes five AP components; verify against the printed set.
V1100 spools have four screw holes; V1000 have five. Match printed revision.
Optional Franka interface components may be omitted for other mounting systems.
Blank quantity cells mean the official material does not establish a number.
Prices and supplier links are intentionally blank for purchasing.
Sources: https://www.orcahand.com/bill-of-materials
Assembly video: https://www.youtube.com/watch?v=TgIz7HiyaoU
Hardware: https://github.com/orcahand/orcahand_hardware
