Thompson-Junyang/ucf-hand-design-project/all files we corrently need/orca_v2/electronics_pcb files and random/ORCA_Motor_Connectors_BOM.xls

Comment | Designator | Footprint | JLCPCB Part #
PM254V-11-03-H85 | H1,H2 | HDR-TH_3P-P2.54-V-F | C541850
