Thompson-Junyang/ucf-hand-design-project/all files we corrently need/orca_v2/base_basic v2 version start with this folder/full v2 hand files/01_Fingers/step_files/R-T-AP.step

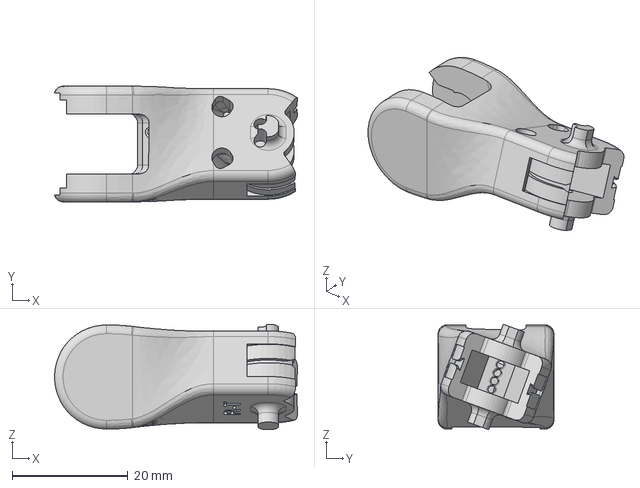
[picture p19: CAD file, 2026-10-17]
all files we corrently need/orca_v2/base_basic v2 version start with this folder/full v2 hand files/01_Fingers/step_files/R-T-AP.step
42.0 x 20.0 x 18.2 mm
