Thompson-Junyang/ucf-hand-design-project/all files we corrently need/orca_v2/base_basic v2 version start with this folder/full v2 hand files/01_Fingers/T-DP.stl

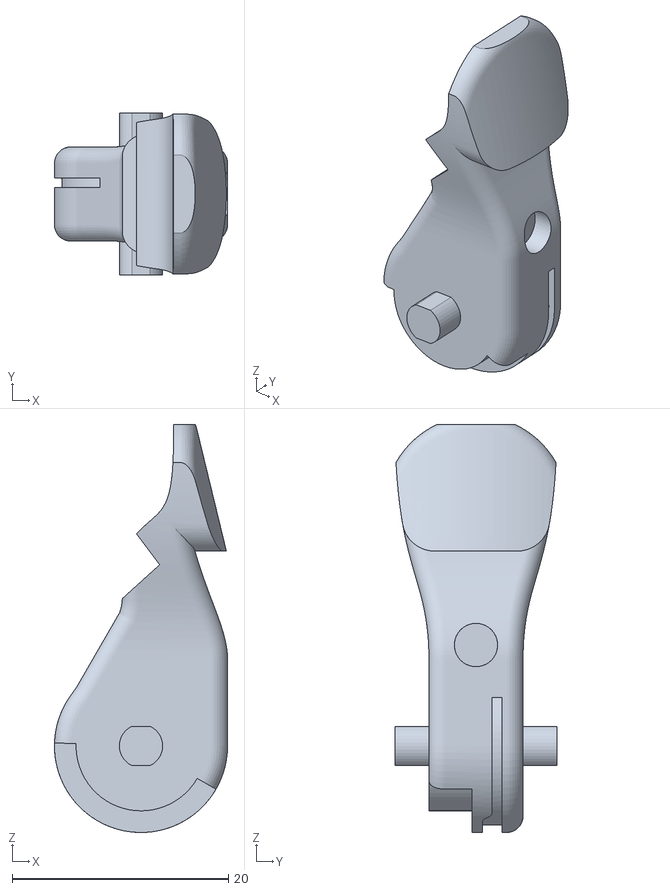
[picture p20: CAD file, 2026-10-17]
all files we corrently need/orca_v2/base_basic v2 version start with this folder/full v2 hand files/01_Fingers/T-DP.stl
16.0 x 15.0 x 37.7
