Thompson-Junyang/ucf-hand-design-project/all files we corrently need/orca_v2/base_basic v2 version start with this folder/full v2 hand files/02_Carpals/R-Carpals_Skin_TPU.stl

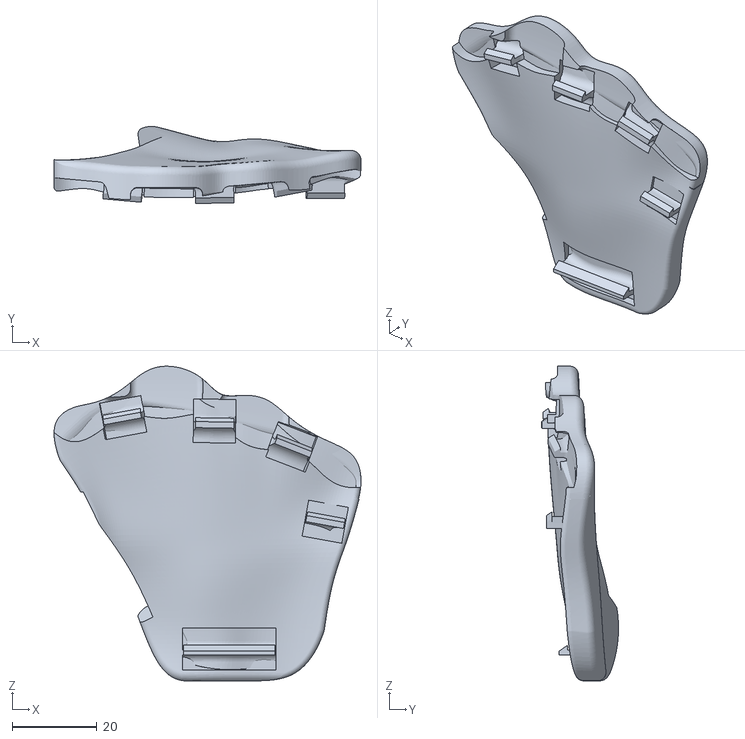
[picture p21: CAD file, 2026-10-17]
all files we corrently need/orca_v2/base_basic v2 version start with this folder/full v2 hand files/02_Carpals/R-Carpals_Skin_TPU.stl
72.2 x 18.2 x 74.0
