Thompson-Junyang/ucf-hand-design-project/all files we corrently need/orca_v2/base_basic v2 version start with this folder/full v2 hand files/02_Carpals/step_files/CarpalsTeeth.step

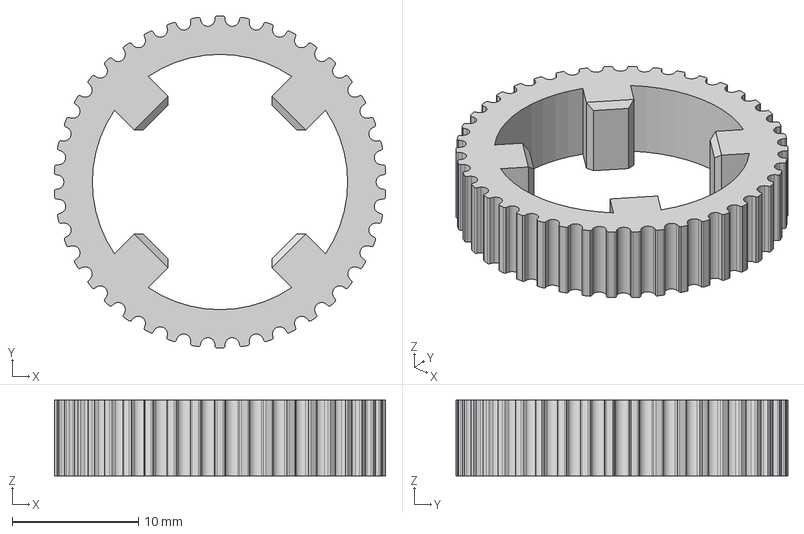
[picture p22: CAD file, 2026-10-17]
all files we corrently need/orca_v2/base_basic v2 version start with this folder/full v2 hand files/02_Carpals/step_files/CarpalsTeeth.step
26.2 x 26.3 x 6.00 mm
