Thompson-Junyang/ucf-hand-design-project/all files we corrently need/orca_v2/base_basic v2 version start with this folder/full v2 hand files/03_Wrist/step_files/WristStructure_Dynamixel.step

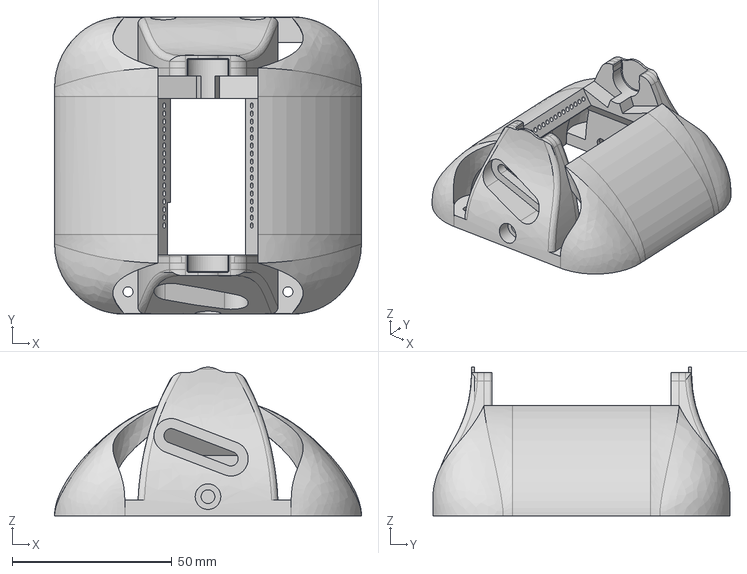
[picture p23: CAD file, 2026-10-17]
all files we corrently need/orca_v2/base_basic v2 version start with this folder/full v2 hand files/03_Wrist/step_files/WristStructure_Dynamixel.step
96.0 x 93.0 x 46.5 mm
