Thompson-Junyang/ucf-hand-design-project/all files we corrently need/orca_v2/base_basic v2 version start with this folder/full v2 hand files/03_Wrist/WristTeeth.stl

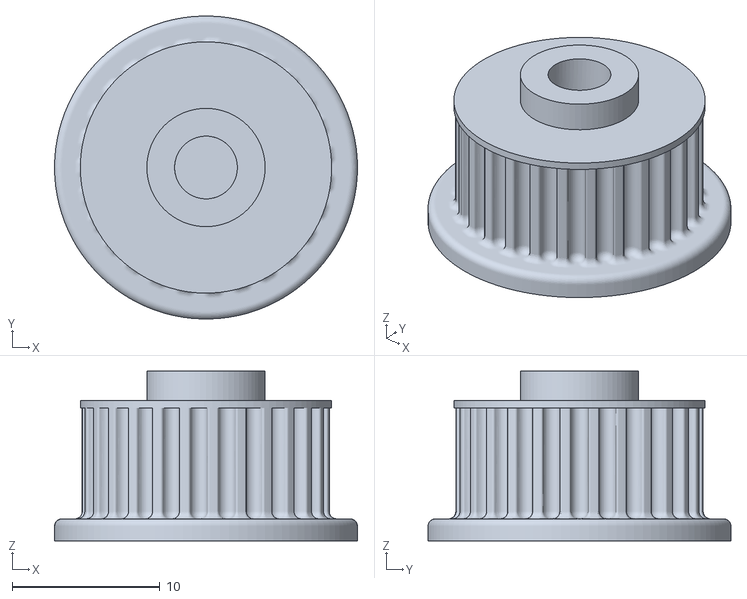
[picture p24: CAD file, 2026-10-17]
all files we corrently need/orca_v2/base_basic v2 version start with this folder/full v2 hand files/03_Wrist/WristTeeth.stl
20.5 x 20.5 x 11.5
