Thompson-Junyang/ucf-hand-design-project/all files we corrently need/orca_v2/base_basic v2 version start with this folder/full v2 hand files/04_ForeArm/FanCover_ORCA.stl

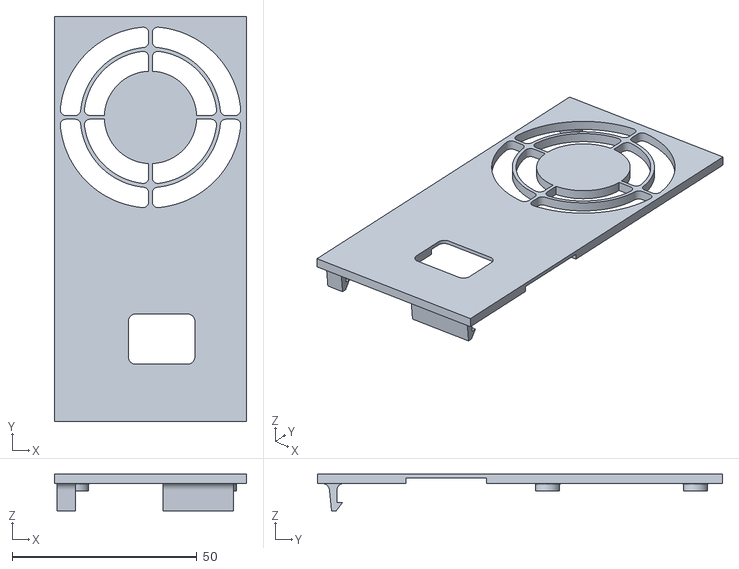
[picture p25: CAD file, 2026-10-17]
all files we corrently need/orca_v2/base_basic v2 version start with this folder/full v2 hand files/04_ForeArm/FanCover_ORCA.stl
52.0 x 109.6 x 9.90
