Thompson-Junyang/ucf-hand-design-project/all files we corrently need/orca_v2/base_basic v2 version start with this folder/full v2 hand files/05_Spools/step_files/Ratchet.step

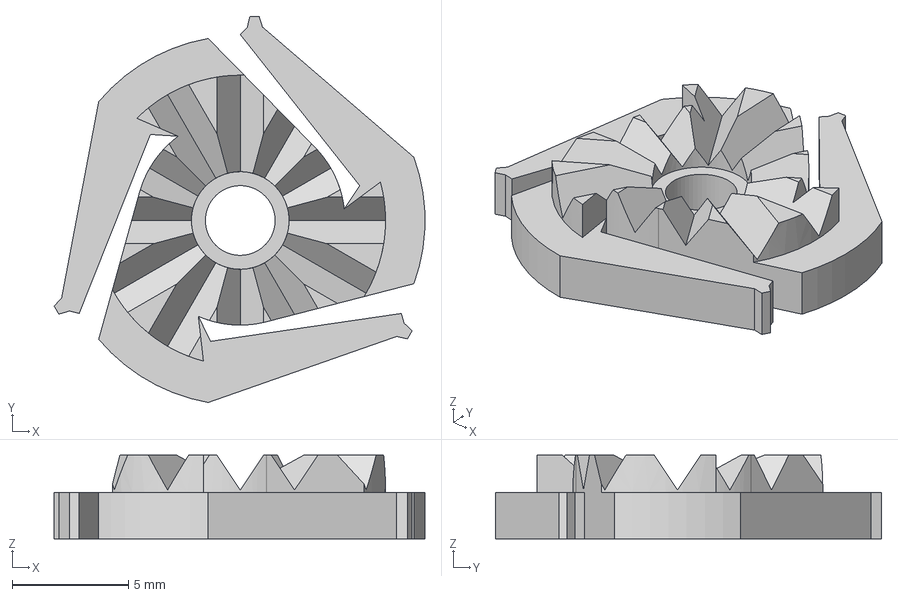
[picture p26: CAD file, 2026-10-17]
all files we corrently need/orca_v2/base_basic v2 version start with this folder/full v2 hand files/05_Spools/step_files/Ratchet.step
15.9 x 16.6 x 3.60 mm
