Thompson-Junyang/ucf-hand-design-project/all files we corrently need/orca_v2/base_basic v2 version start with this folder/full v2 hand files/06_CNC/FrankaConnector.step

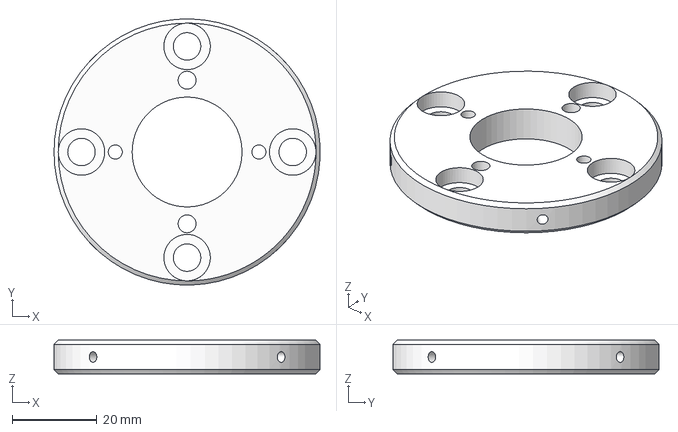
[picture p27: CAD file, 2026-10-17]
all files we corrently need/orca_v2/base_basic v2 version start with this folder/full v2 hand files/06_CNC/FrankaConnector.step
63.0 x 63.0 x 8.00 mm
