Thompson-Junyang/ucf-hand-design-project/all files we corrently need/orca_v2/base_basic v2 version start with this folder/full v2 hand files/07_Molds/DP-SkinMold_M-DP-SkinMold_TopMold.stl

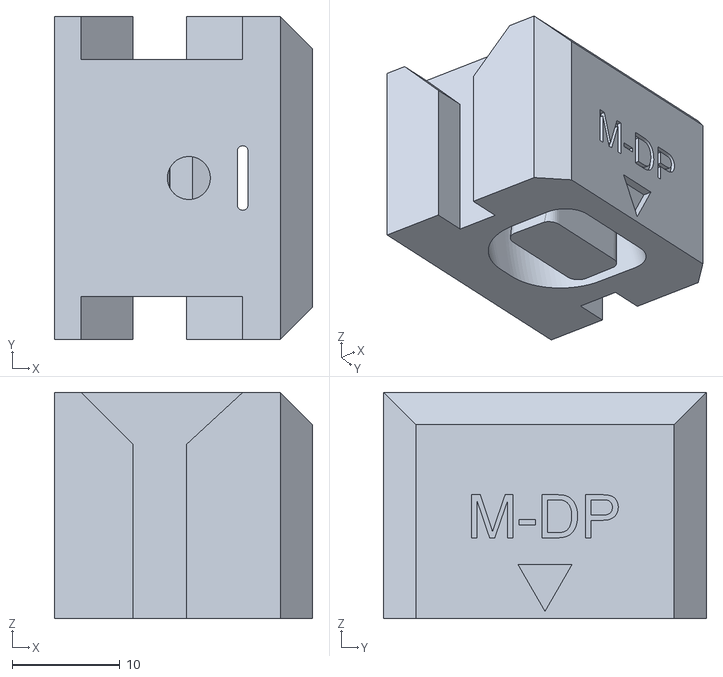
[picture p28: CAD file, 2026-10-17]
all files we corrently need/orca_v2/base_basic v2 version start with this folder/full v2 hand files/07_Molds/DP-SkinMold_M-DP-SkinMold_TopMold.stl
24.0 x 30.0 x 21.0
