Thompson-Junyang/ucf-hand-design-project/all files we corrently need/orca_v2/base_basic v2 version start with this folder/full v2 hand files/09_Skin/PP-Skin_T-PP-Skin_Skin.stl

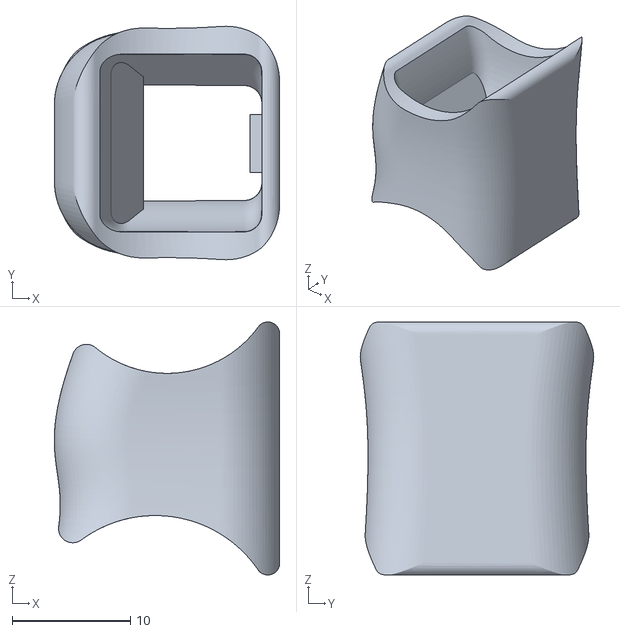
[picture p29: CAD file, 2026-10-17]
all files we corrently need/orca_v2/base_basic v2 version start with this folder/full v2 hand files/09_Skin/PP-Skin_T-PP-Skin_Skin.stl
19.0 x 19.7 x 21.4
