Thompson-Junyang/ucf-hand-design-project/all files we corrently need/orca_v2/base_basic v2 version start with this folder/full v2 hand files/SiliconeMolds-1100.3mf

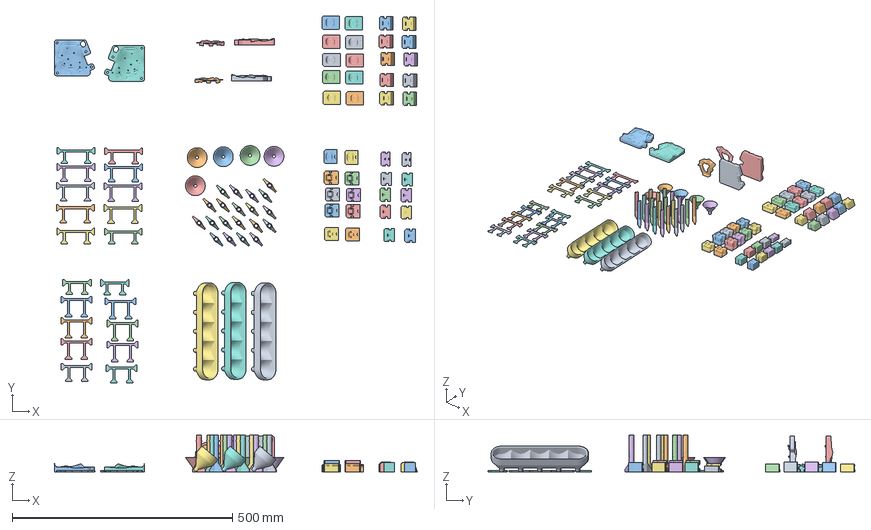
[picture p30: CAD file, 2026-10-17]
all files we corrently need/orca_v2/base_basic v2 version start with this folder/full v2 hand files/SiliconeMolds-1100.3mf
824.6 x 833.4 x 84.0 mm
L-CarpalsMold-A-Funnel.stl
Cylinder.stl x 20
L-CarpalsMold-B-Funnel.stl
R-CarpalsMold-A-Funnel.stl
R-CarpalsMold-B-Funnel.stl
CORE-L.stl
DP-SkinMold_M-DP-SkinMold_Clip.stl x 6
CORE-R.stl
DP-SkinMold_P-DP-SkinMold_Clip.stl x 2
PP-SkinMold_T-PP-Skinmold_BottomMold.stl x 2
PP-SkinMold_I-PP-SkinMold_BottomMold.stl x 2
PP-SkinMold_P-PP-SkinMold_BottomMold.stl x 2
M-DP-SkinMold_BottomMold.stl x 6
T-DP-BottomMold.stl x 2
PP-SkinMold_I-PP-SkinMold_TopMold.stl x 2
PP-SkinMold_P-PP-SkinMold_TopMold.stl x 2
DP-SkinMold_M-DP-SkinMold_TopMold.stl x 6
T-DP-Clip.stl x 2
T-DP-TopMold.stl x 2
P-DP-SkinMold_BottomMold.stl x 2
P-DP-SkinMold_TopMold.stl x 2
PP-SkinMold_M-PP-SkinMold_BottomMold.stl x 4
PP-SkinMold_M-PP-SkinMold_TopMold.stl x 4
PP-SkinMold_T-PP-Skinmold_TopMold.stl x 2
PP-SkinMold_I-PP-SkinMold_Clip.stl x 2
PP-SkinMold_P-PP-SkinMold_Clip.stl x 2
PP-SkinMold_T-PP-Skinmold_Clip.stl x 2
PP-SkinMold_M-PP-SkinMold_Clip.stl x 4
PentaFunnel.stl x 3
SingleFunnel.stl x 5
