Thompson-Junyang/ucf-hand-design-project/all files we corrently need/orca_v2/lite_a simple verson of v2 we dont need/IP_M-IP-Lite_IP.stl

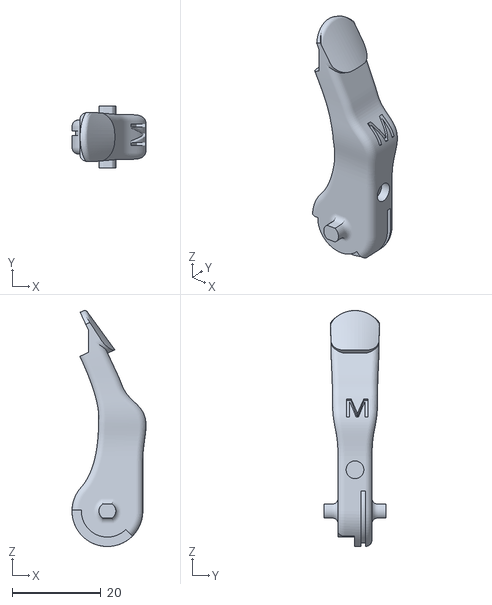
[picture p31: CAD file, 2026-10-17]
all files we corrently need/orca_v2/lite_a simple verson of v2 we dont need/IP_M-IP-Lite_IP.stl
16.7 x 14.0 x 53.3
