Thompson-Junyang/ucf-hand-design-project/all files we corrently need/orca_v2/touch_the version that allows us to add touch sensor/01_Fingers/P-IP-Touch.stl

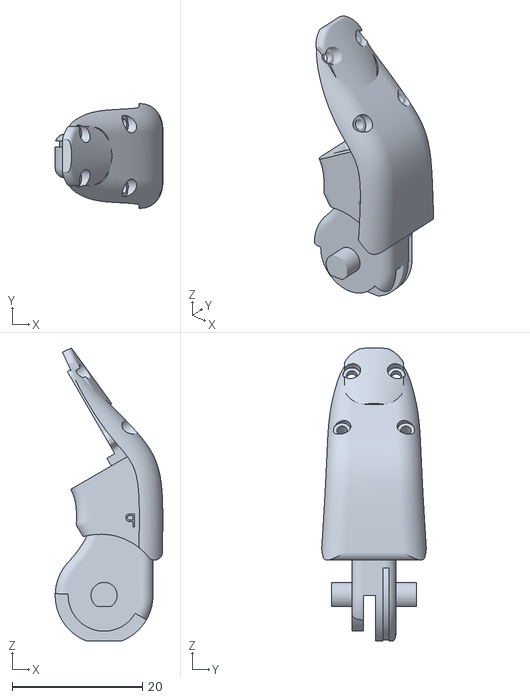
[picture p32: CAD file, 2026-10-17]
all files we corrently need/orca_v2/touch_the version that allows us to add touch sensor/01_Fingers/P-IP-Touch.stl
16.5 x 16.0 x 44.9
