Thompson-Junyang/ucf-hand-design-project/all files we corrently need/orca_v2/touch_the version that allows us to add touch sensor/01_Fingers/step_files/T-TP-L-Touch.step

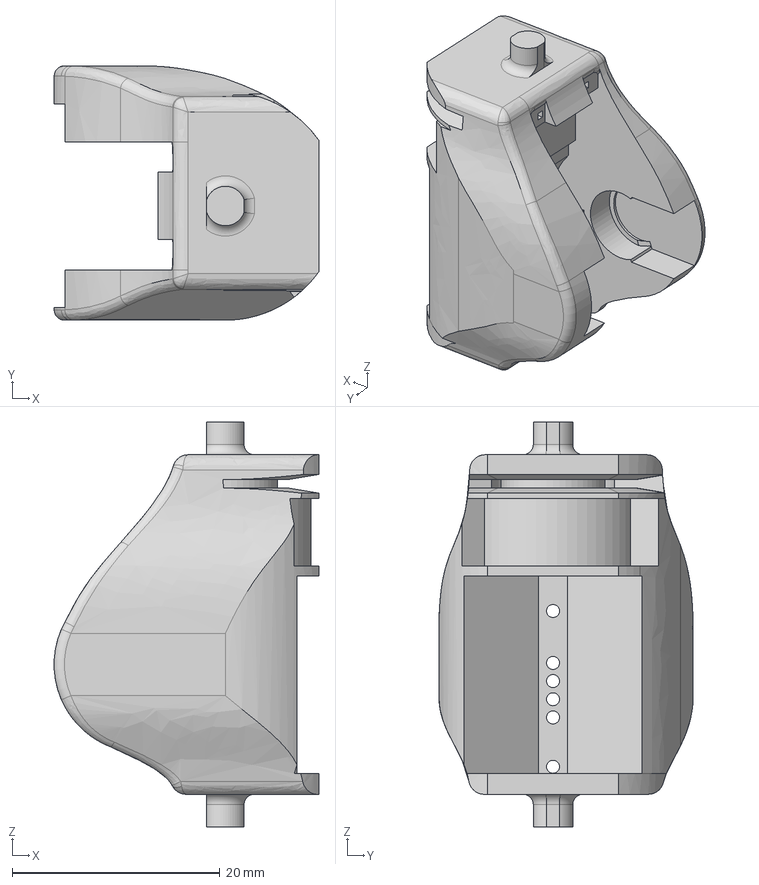
[picture p33: CAD file, 2026-10-17]
all files we corrently need/orca_v2/touch_the version that allows us to add touch sensor/01_Fingers/step_files/T-TP-L-Touch.step
25.5 x 24.5 x 39.0 mm
