Thompson-Junyang/ucf-hand-design-project/all files we corrently need/orca_v2/touch_the version that allows us to add touch sensor/02_Carpals/step_files/Coav-L.step

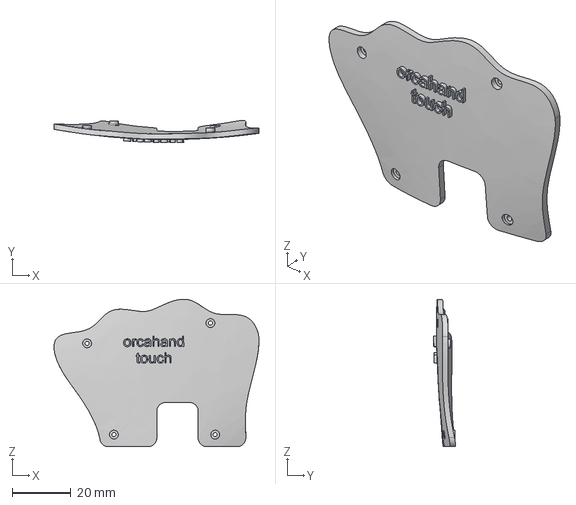
[picture p34: CAD file, 2026-10-17]
all files we corrently need/orca_v2/touch_the version that allows us to add touch sensor/02_Carpals/step_files/Coav-L.step
69.5 x 7.46 x 50.0 mm
