Thompson-Junyang/ucf-hand-design-project/all files we corrently need/orca_v2/touch_the version that allows us to add touch sensor/SiliconeMolds-2100.3mf

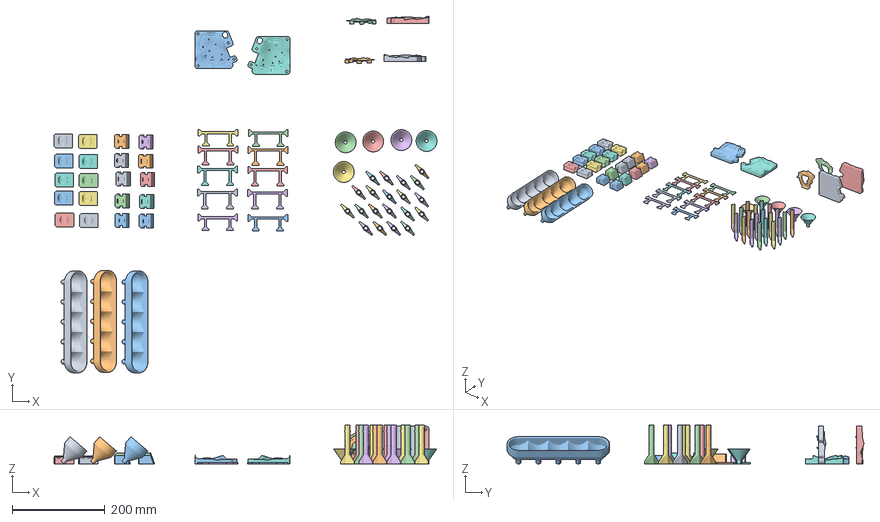
[picture p35: CAD file, 2026-10-17]
all files we corrently need/orca_v2/touch_the version that allows us to add touch sensor/SiliconeMolds-2100.3mf
826.3 x 769.6 x 84.0 mm
L-CarpalsMold-A-Funnel.stl
Cylinder.stl x 20
L-CarpalsMold-B-Funnel.stl
R-CarpalsMold-A-Funnel.stl
R-CarpalsMold-B-Funnel.stl
CORE-L.stl
CORE-R.stl
PP-SkinMold_T-PP-Skinmold_BottomMold.stl x 2
PP-SkinMold_I-PP-SkinMold_BottomMold.stl x 2
PP-SkinMold_P-PP-SkinMold_BottomMold.stl x 2
PP-SkinMold_I-PP-SkinMold_TopMold.stl x 2
PP-SkinMold_P-PP-SkinMold_TopMold.stl x 2
PP-SkinMold_M-PP-SkinMold_BottomMold.stl x 4
PP-SkinMold_M-PP-SkinMold_TopMold.stl x 4
PP-SkinMold_T-PP-Skinmold_TopMold.stl x 2
PP-SkinMold_I-PP-SkinMold_Clip.stl x 2
PP-SkinMold_P-PP-SkinMold_Clip.stl x 2
PP-SkinMold_T-PP-Skinmold_Clip.stl x 2
PP-SkinMold_M-PP-SkinMold_Clip.stl x 4
PentaFunnel.stl x 3
SingleFunnel.stl x 5
