Thompson-Junyang/ucf-hand-design-project/full files check it out if have time/orca_v2/base/02_Carpals/Coav-R.stl

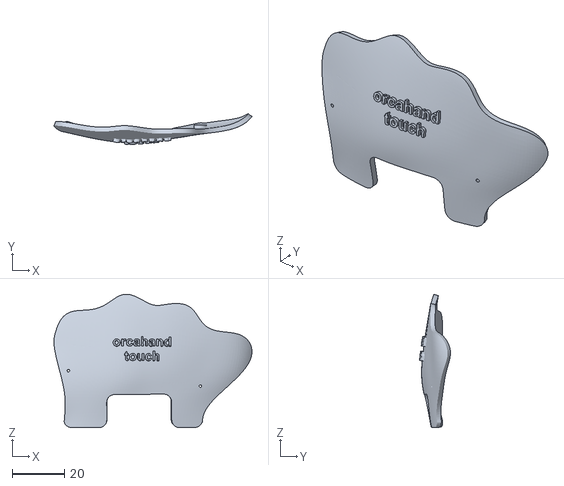
[picture p37: CAD file, 2026-10-17]
full files check it out if have time/orca_v2/base/02_Carpals/Coav-R.stl
75.8 x 11.8 x 51.1
