Thompson-Junyang/ucf-hand-design-project/full files check it out if have time/orca_v2/base/02_Carpals/step_files/R-Carpals.step

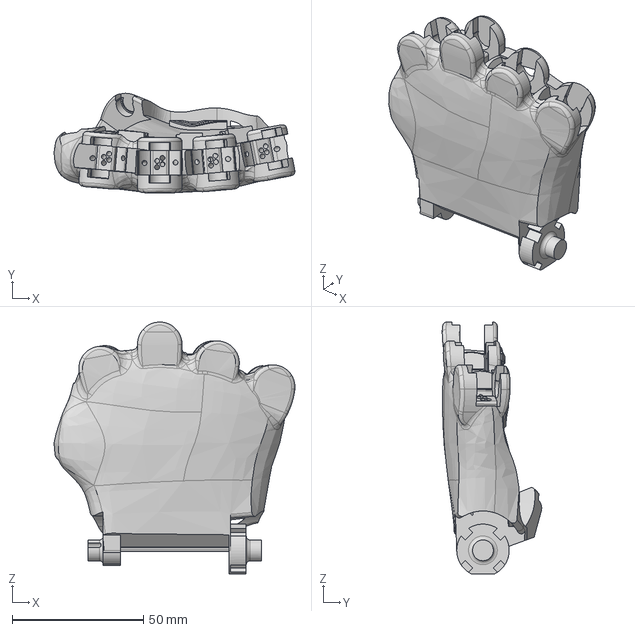
[picture p38: CAD file, 2026-10-17]
full files check it out if have time/orca_v2/base/02_Carpals/step_files/R-Carpals.step
91.8 x 37.9 x 96.0 mm
