Thompson-Junyang/ucf-hand-design-project/full files check it out if have time/orca_v2/base/03_Wrist/step_files/CableHolder-A.step

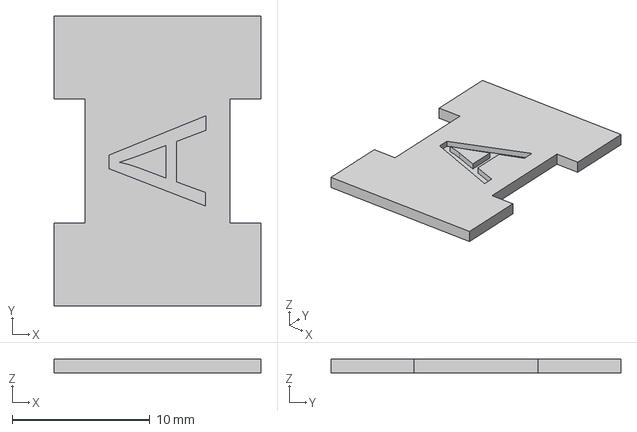
[picture p39: CAD file, 2026-10-17]
full files check it out if have time/orca_v2/base/03_Wrist/step_files/CableHolder-A.step
15.0 x 21.0 x 1.00 mm
