Thompson-Junyang/ucf-hand-design-project/full files check it out if have time/orca_v2/base/04_ForeArm/HullBackDynamixel.stl

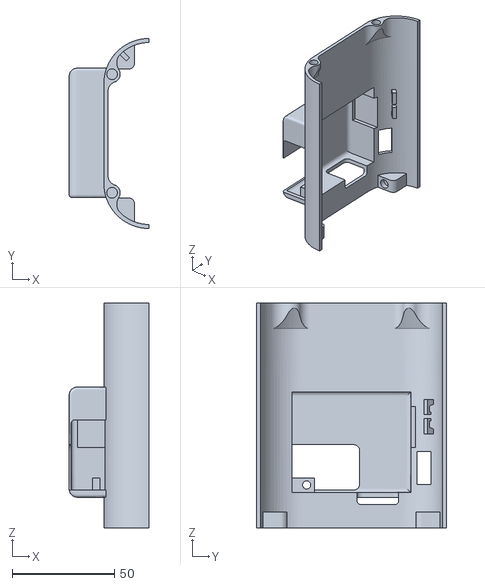
[picture p40: CAD file, 2026-10-17]
full files check it out if have time/orca_v2/base/04_ForeArm/HullBackDynamixel.stl
39.0 x 93.0 x 110.1
