Thompson-Junyang/ucf-hand-design-project/full files check it out if have time/orca_v2/base/04_ForeArm/step_files/ForeArmStructure_Dynamixel.step

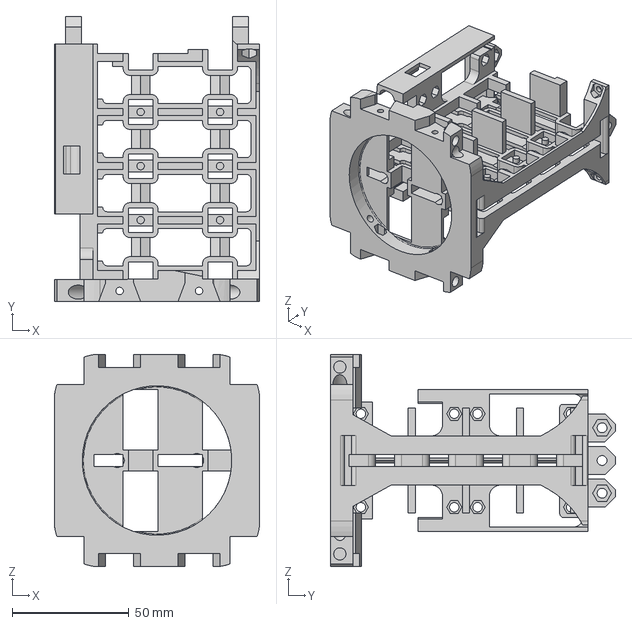
[picture p41: CAD file, 2026-10-17]
full files check it out if have time/orca_v2/base/04_ForeArm/step_files/ForeArmStructure_Dynamixel.step
88.0 x 122.1 x 91.0 mm
