Thompson-Junyang/ucf-hand-design-project/full files check it out if have time/orca_v2/base/05_Spools/step_files/SpoolTensioner.step

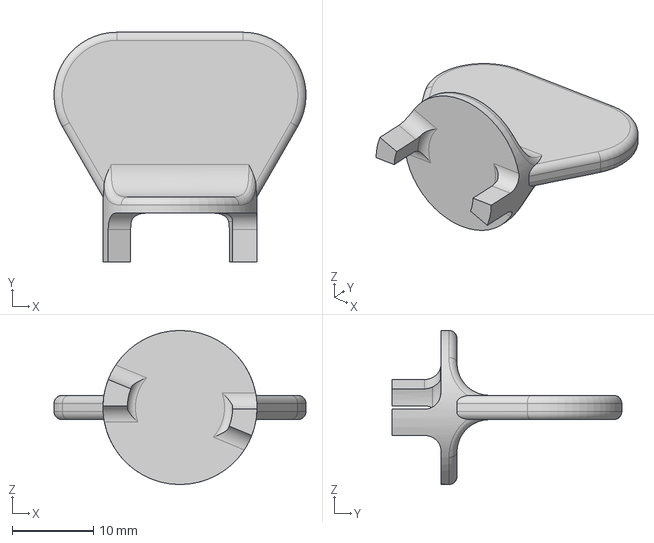
[picture p42: CAD file, 2026-10-17]
full files check it out if have time/orca_v2/base/05_Spools/step_files/SpoolTensioner.step
31.1 x 28.3 x 19.0 mm
