Thompson-Junyang/ucf-hand-design-project/full files check it out if have time/orca_v2/base/06_CNC/SpoolHolder_CNC.step

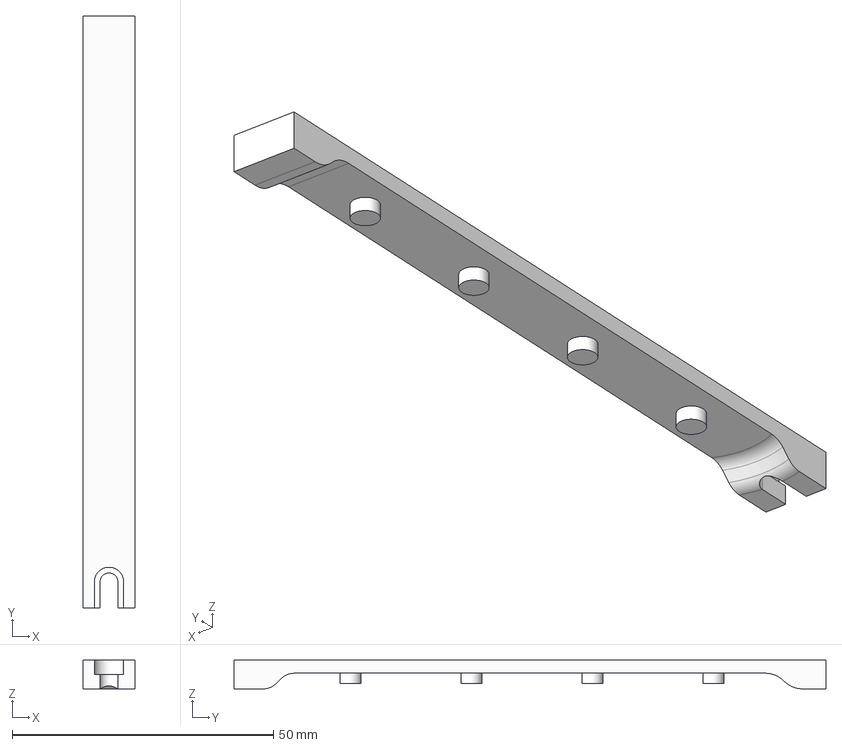
[picture p43: CAD file, 2026-10-17]
full files check it out if have time/orca_v2/base/06_CNC/SpoolHolder_CNC.step
10.0 x 113.3 x 5.50 mm
