Thompson-Junyang/ucf-hand-design-project/full files check it out if have time/orca_v2/base/07_Molds/DP-SkinMold_P-DP-SkinMold_BottomMold.stl

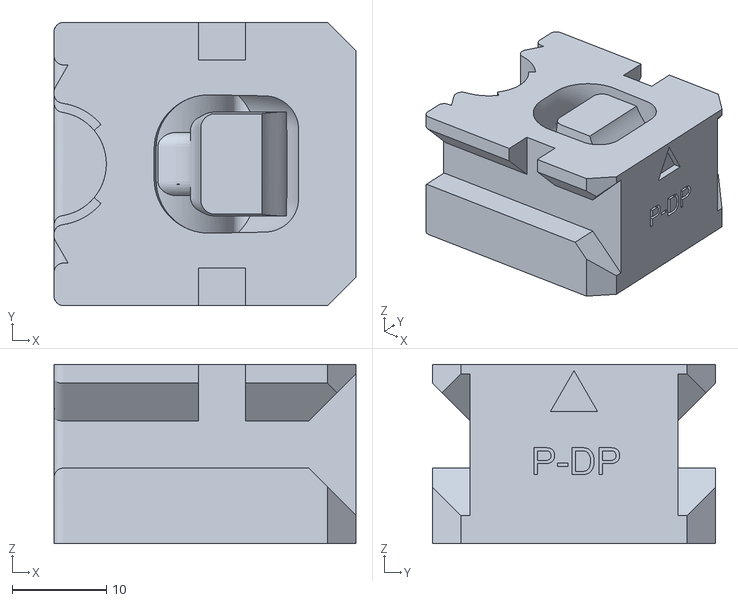
[picture p44: CAD file, 2026-10-17]
full files check it out if have time/orca_v2/base/07_Molds/DP-SkinMold_P-DP-SkinMold_BottomMold.stl
32.0 x 30.0 x 19.0
