Thompson-Junyang/ucf-hand-design-project/full files check it out if have time/orca_v2/base/09_Skin/PP-Skin_M-PP-Skin_Skin.stl

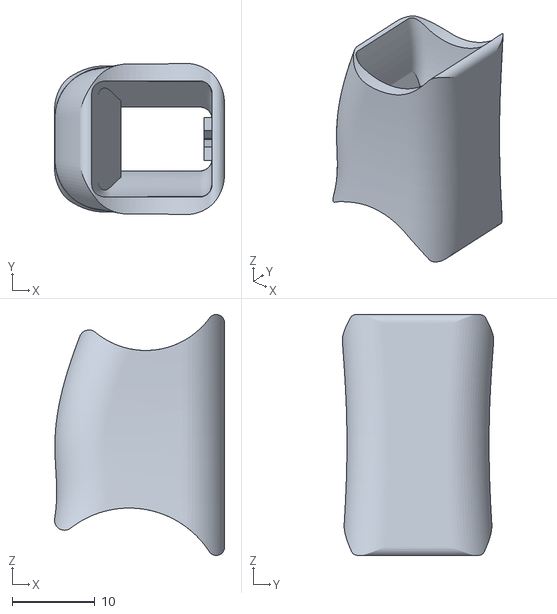
[picture p45: CAD file, 2026-10-17]
full files check it out if have time/orca_v2/base/09_Skin/PP-Skin_M-PP-Skin_Skin.stl
20.5 x 18.3 x 29.1
