Thompson-Junyang/ucf-hand-design-project/full files check it out if have time/orca_v2/touch/01_Fingers/I-AP-R-Touch.stl

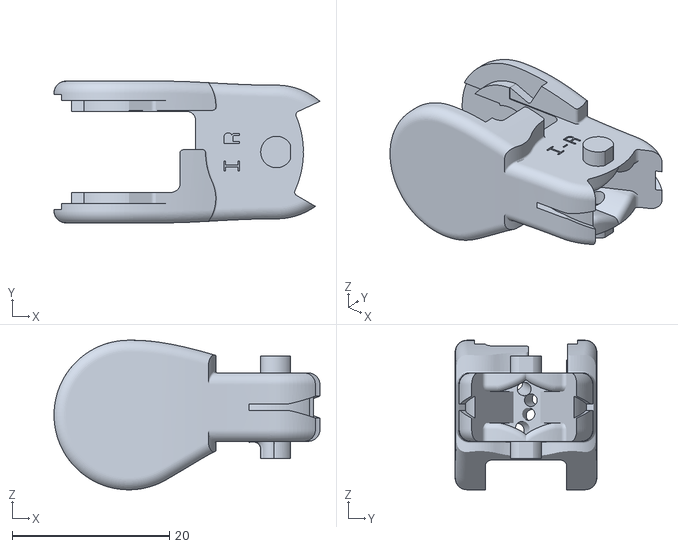
[picture p46: CAD file, 2026-10-17]
full files check it out if have time/orca_v2/touch/01_Fingers/I-AP-R-Touch.stl
33.8 x 18.0 x 19.0
