Thompson-Junyang/ucf-hand-design-project/full files check it out if have time/orca_v2/touch/02_Carpals/step_files/Carpals-L-Touch.step

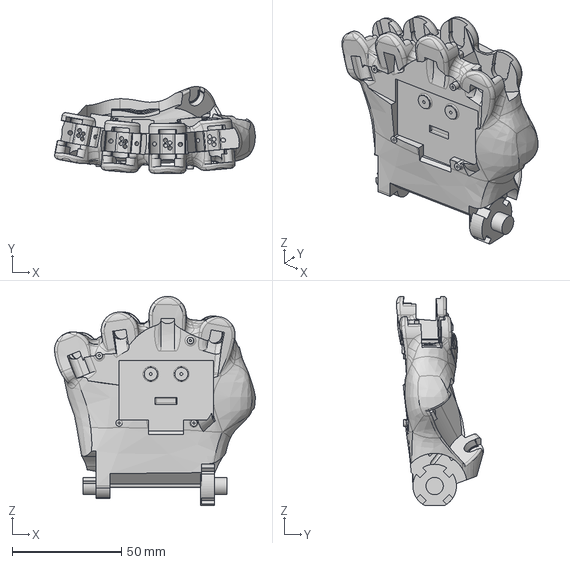
[picture p47: CAD file, 2026-10-17]
full files check it out if have time/orca_v2/touch/02_Carpals/step_files/Carpals-L-Touch.step
92.2 x 39.9 x 96.0 mm
