Thompson-Junyang/ucf-hand-design-project/all files we corrently need/orca_v2/base_basic v2 version start with this folder/full v2 hand files/01_Fingers/step_files/I-IP.step

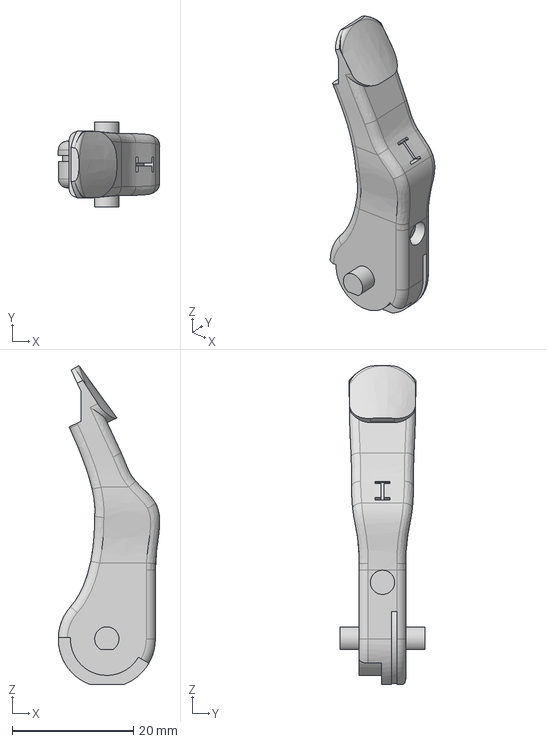
[picture p48: CAD file, 2026-10-17]
all files we corrently need/orca_v2/base_basic v2 version start with this folder/full v2 hand files/01_Fingers/step_files/I-IP.step
16.7 x 14.0 x 52.5 mm
