Thompson-Junyang/ucf-hand-design-project/all files we corrently need/orca_v2/base_basic v2 version start with this folder/full v2 hand files/02_Carpals/CORE-R.stl

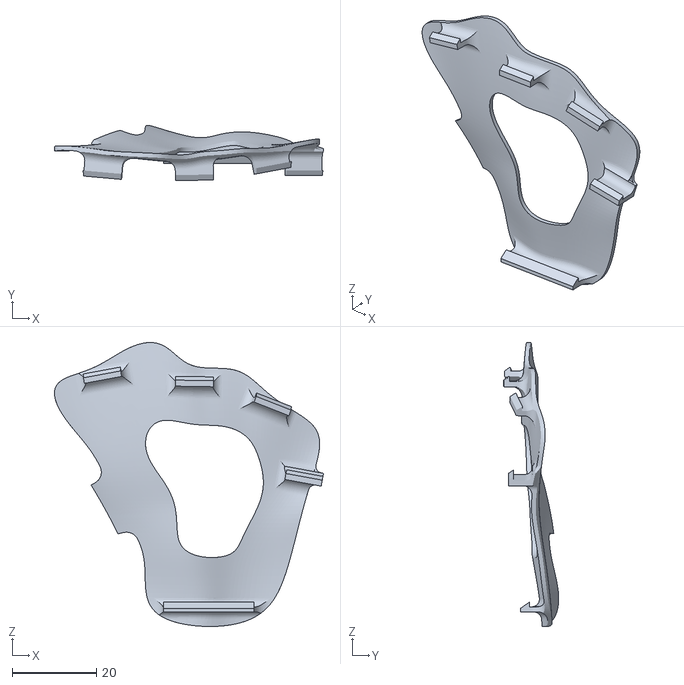
[picture p49: CAD file, 2026-10-17]
all files we corrently need/orca_v2/base_basic v2 version start with this folder/full v2 hand files/02_Carpals/CORE-R.stl
63.8 x 13.1 x 67.3
