Thompson-Junyang/ucf-hand-design-project/all files we corrently need/orca_v2/base_basic v2 version start with this folder/full v2 hand files/Prints-1100.3mf

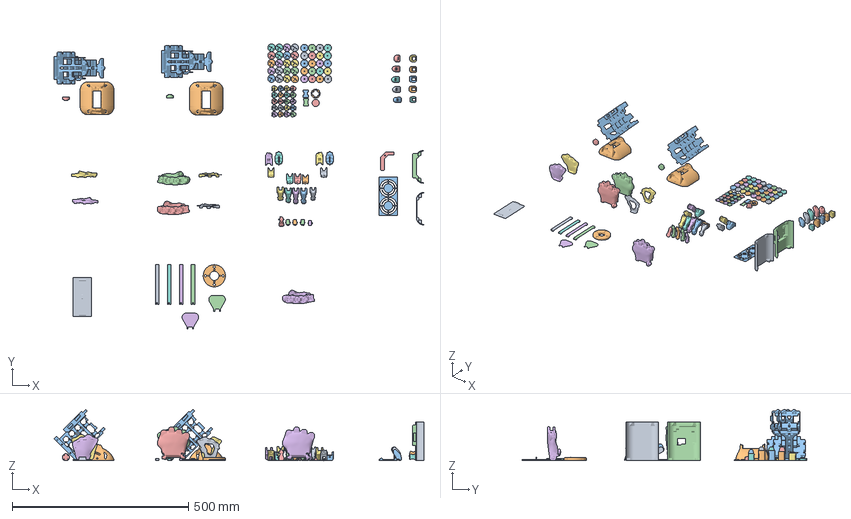
[picture p51: CAD file, 2026-10-17]
all files we corrently need/orca_v2/base_basic v2 version start with this folder/full v2 hand files/Prints-1100.3mf
1050.5 x 809.4 x 145.2 mm
HullFront.stl
FrankaConnector
PP-Skin_M-PP-Skin_Skin.stl x 2
SpoolHolder x 4
DP-Skin_M-DP-Skin_Skin.stl x 3
PP-Skin_T-PP-Skin_Skin.stl
PP-Skin_I-PP-Skin_Skin.stl
DP-Skin_P-DP-Skin_Skin.stl
SpoolTensioner.stl x 2
T-DP_Skin.stl
CORE-L.stl
PP-Skin_P-PP-Skin_Skin.stl
CORE-R.stl
WristStructure_Dynamixel.stl
FanCover_TwoFans.stl
L-Carpals.stl
R-Carpals.stl x 2
M-PP.stl x 2
T-PP.stl
I-PP.stl
P-PP.stl
M-IP.stl x 2
T-TP-R.stl
I-IP.stl
T-DP.stl
P-IP.stl
R-T-AP.stl
M-AP.stl x 2
I-AP-R.stl
P-AP.stl
L-T-AP.stl
I-AP-L.stl
T-TP-L.stl
SidePlate.step
WristStructure_Feetech.stl
ForeArmStructure_Feetech_TwoFans.stl
HullBack.stl
HullBack_CableCover.stl
L-Carpals_Skin_TPU.stl
R-Carpals_Skin_TPU.stl
ForeArmStructure_Dynamixel_TwoFans.stl
WristAdapter_Feetech.stl
WristAdapter_Dynamixel.stl
BaseSpool.stl x 20
SpoolCover.stl x 20
Ratchet.stl x 20
CarpalsTeeth.stl
CableHolder-B.stl
CableHolder-A.stl
WristTeeth.stl
