Thompson-Junyang/ucf-hand-design-project/all files we corrently need/orca_v2/lite_a simple verson of v2 we dont need/LiteTower.step

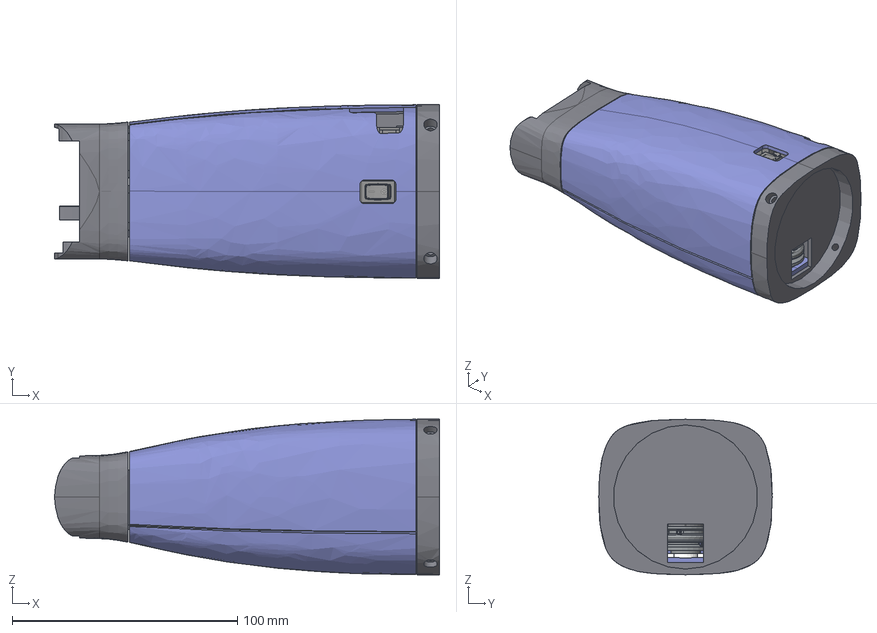
[picture p52: CAD file, 2026-10-17]
all files we corrently need/orca_v2/lite_a simple verson of v2 we dont need/LiteTower.step
171.0 x 77.1 x 69.1 mm
BaseSpool
BaseSpool_1
BaseSpool_2
BaseSpool_3
90591A265_Zinc-Plated Steel Hex Nut x 3
BaseSpool_4
DIN 912 - M2 x 0.4 x 4 Steel 4.6 Plain x 6
RatchetExp x 3
SpoolCoverM4 x 3
4x8x3 x 3
DIN 912 - M2.5 x 0.45 x 8 Steel 4.6 Plain x 3
BaseSpool_5
BaseSpool_6
Logo
