Thompson-Junyang/ucf-hand-design-project/all files we corrently need/orca_v2/touch_the version that allows us to add touch sensor/01_Fingers/T-DP-Touch.stl

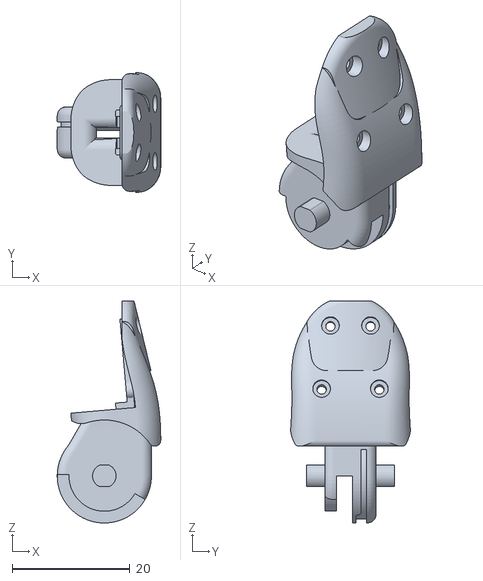
[picture p53: CAD file, 2026-10-17]
all files we corrently need/orca_v2/touch_the version that allows us to add touch sensor/01_Fingers/T-DP-Touch.stl
17.6 x 20.3 x 37.7
