Thompson-Junyang/ucf-hand-design-project/full files check it out if have time/orca_v2/base/01_Fingers/step_files/P-AP.step

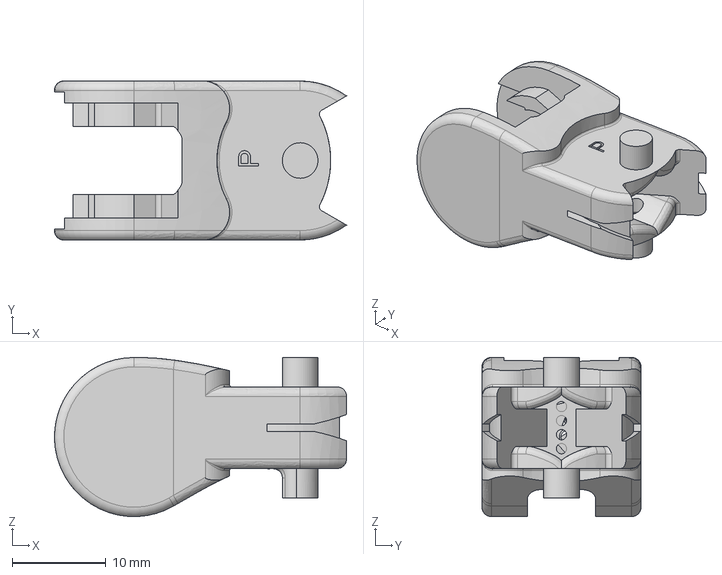
[picture p54: CAD file, 2026-10-17]
full files check it out if have time/orca_v2/base/01_Fingers/step_files/P-AP.step
31.2 x 17.0 x 17.0 mm
