Thompson-Junyang/ucf-hand-design-project/full files check it out if have time/orca_v2/base/03_Wrist/step_files/CableHolder-B.step

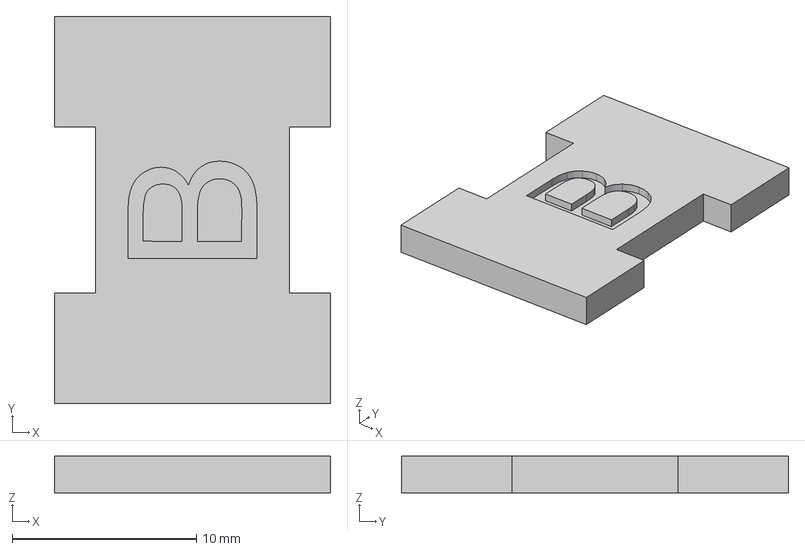
[picture p55: CAD file, 2026-10-17]
full files check it out if have time/orca_v2/base/03_Wrist/step_files/CableHolder-B.step
15.0 x 21.0 x 2.00 mm
