Thompson-Junyang/ucf-hand-design-project/full files check it out if have time/orca_v2/base/04_ForeArm/HullBack_CableCover.stl

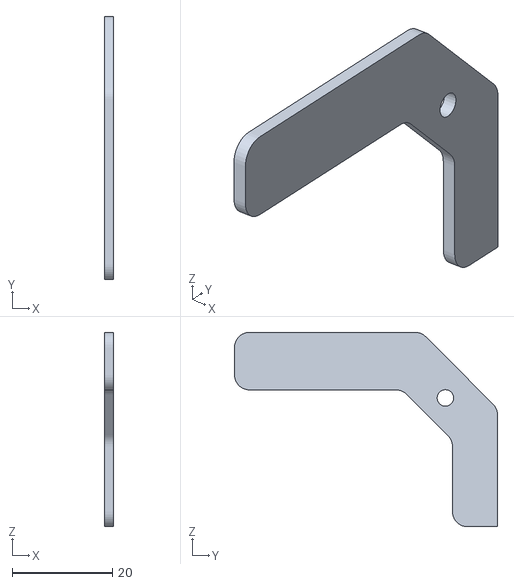
[picture p56: CAD file, 2026-10-17]
full files check it out if have time/orca_v2/base/04_ForeArm/HullBack_CableCover.stl
1.85 x 52.5 x 38.8
