Thompson-Junyang/ucf-hand-design-project/full files check it out if have time/orca_v2/base/04_ForeArm/step_files/HullFront.step

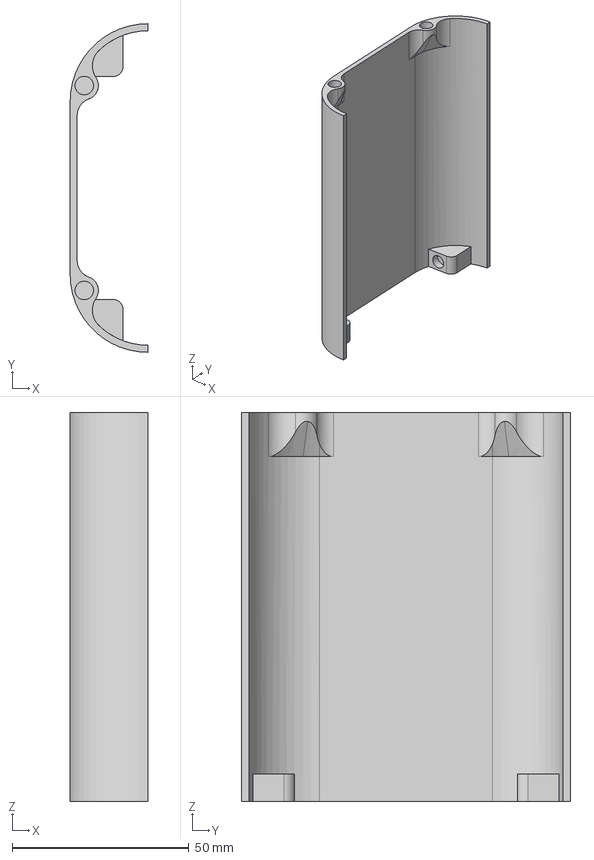
[picture p57: CAD file, 2026-10-17]
full files check it out if have time/orca_v2/base/04_ForeArm/step_files/HullFront.step
22.0 x 93.0 x 110.1 mm
