Thompson-Junyang/ucf-hand-design-project/full files check it out if have time/orca_v2/base/09_Skin/PP-Skin_I-PP-Skin_Skin.stl

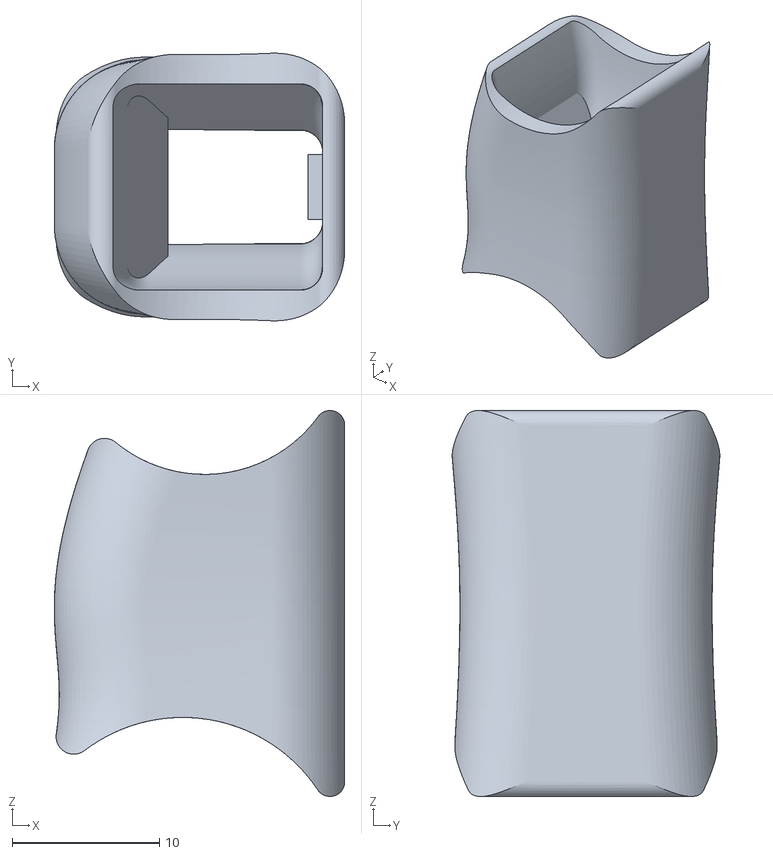
[picture p59: CAD file, 2026-10-17]
full files check it out if have time/orca_v2/base/09_Skin/PP-Skin_I-PP-Skin_Skin.stl
19.7 x 18.2 x 26.2
