Thompson-Junyang/ucf-hand-design-project/full files check it out if have time/orca_v2/lite/T-PP-Lite.step

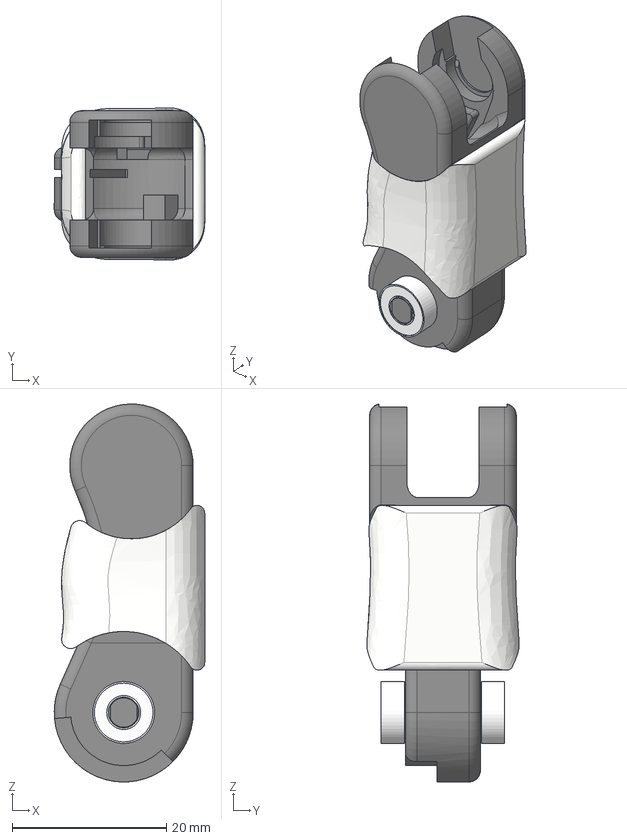
[picture p60: CAD file, 2026-10-17]
full files check it out if have time/orca_v2/lite/T-PP-Lite.step
19.5 x 19.8 x 49.0 mm
4x8x3
4x8x3(Mirror)
