Thompson-Junyang/ucf-hand-design-project/full files check it out if have time/orca_v2/touch/01_Fingers/step_files/R-T-AP-Touch.step

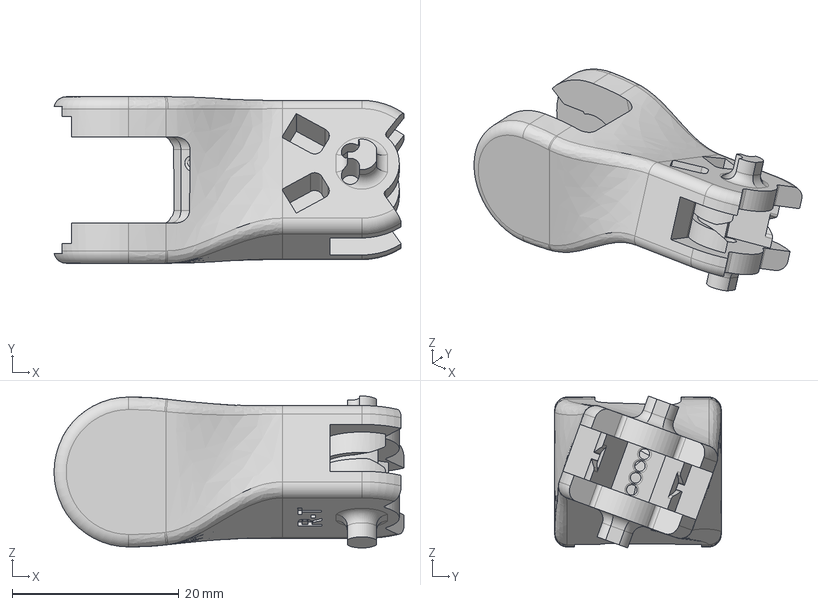
[picture p61: CAD file, 2026-10-17]
full files check it out if have time/orca_v2/touch/01_Fingers/step_files/R-T-AP-Touch.step
42.0 x 20.0 x 18.2 mm
