Thompson-Junyang/ucf-hand-design-project/all files we corrently need/orca_v2/base_basic v2 version start with this folder/full v2 hand files/01_Fingers/step_files/M-PP.step

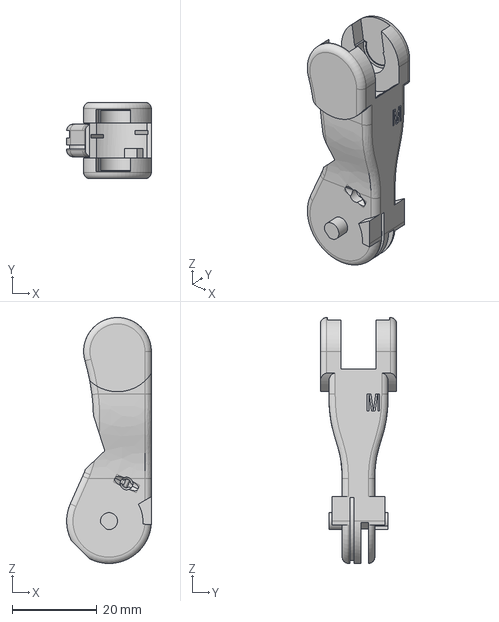
[picture p62: CAD file, 2026-10-17]
all files we corrently need/orca_v2/base_basic v2 version start with this folder/full v2 hand files/01_Fingers/step_files/M-PP.step
20.0 x 18.0 x 58.0 mm
