Thompson-Junyang/ucf-hand-design-project/all files we corrently need/orca_v2/base_basic v2 version start with this folder/full v2 hand files/03_Wrist/step_files/WristAdapter_Feetech.step

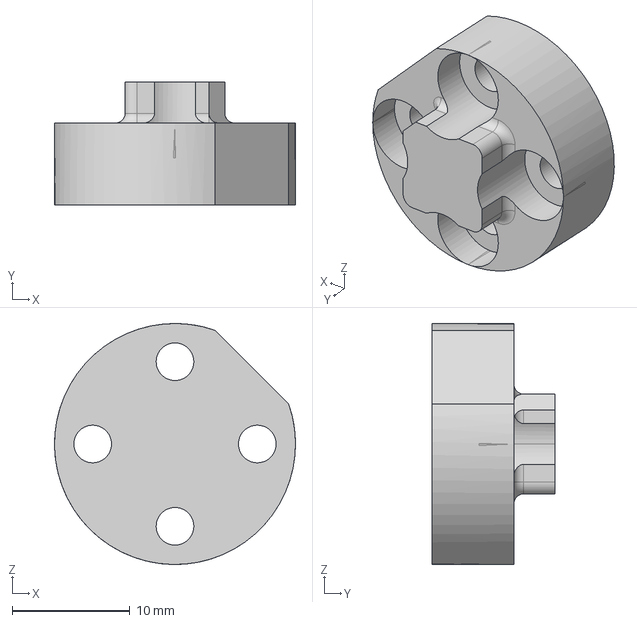
[picture p63: CAD file, 2026-10-17]
all files we corrently need/orca_v2/base_basic v2 version start with this folder/full v2 hand files/03_Wrist/step_files/WristAdapter_Feetech.step
20.5 x 10.5 x 20.5 mm
