Thompson-Junyang/ucf-hand-design-project/all files we corrently need/orca_v2/base_basic v2 version start with this folder/full v2 hand files/04_ForeArm/HullBackFeetech.stl

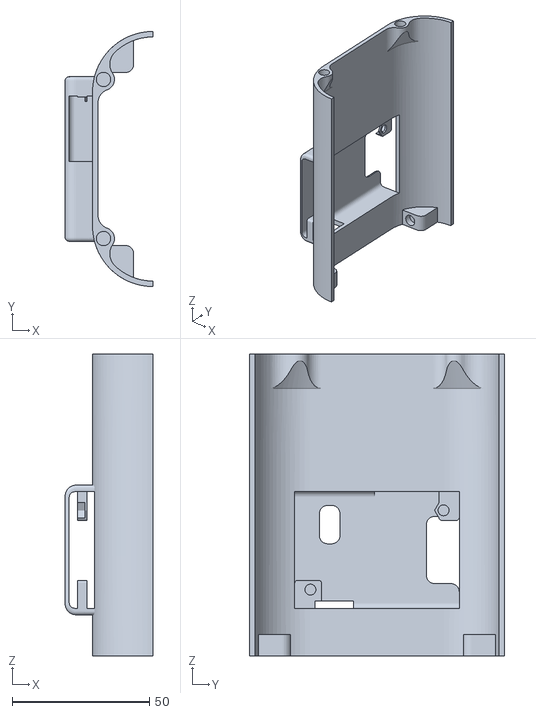
[picture p64: CAD file, 2026-10-17]
all files we corrently need/orca_v2/base_basic v2 version start with this folder/full v2 hand files/04_ForeArm/HullBackFeetech.stl
32.0 x 93.0 x 110.1
