Thompson-Junyang/ucf-hand-design-project/all files we corrently need/orca_v2/base_basic v2 version start with this folder/full v2 hand files/05_Spools/step_files/SpoolCover.step

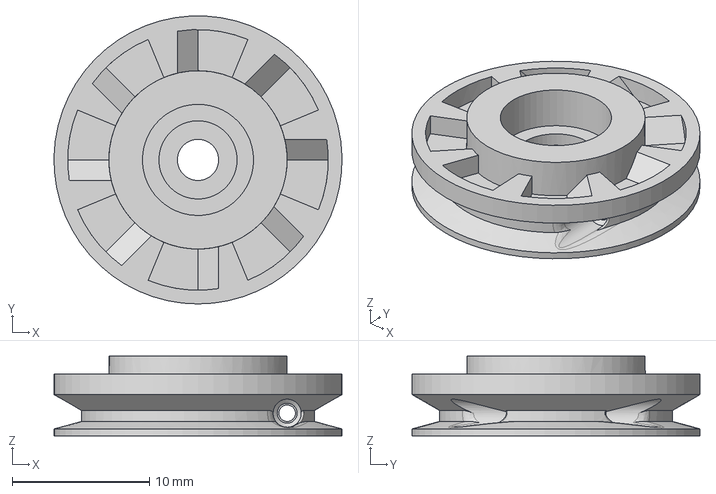
[picture p65: CAD file, 2026-10-17]
all files we corrently need/orca_v2/base_basic v2 version start with this folder/full v2 hand files/05_Spools/step_files/SpoolCover.step
21.0 x 21.0 x 5.80 mm
