Thompson-Junyang/ucf-hand-design-project/all files we corrently need/orca_v2/base_basic v2 version start with this folder/full v2 hand files/07_Molds/Clips-Only.3mf

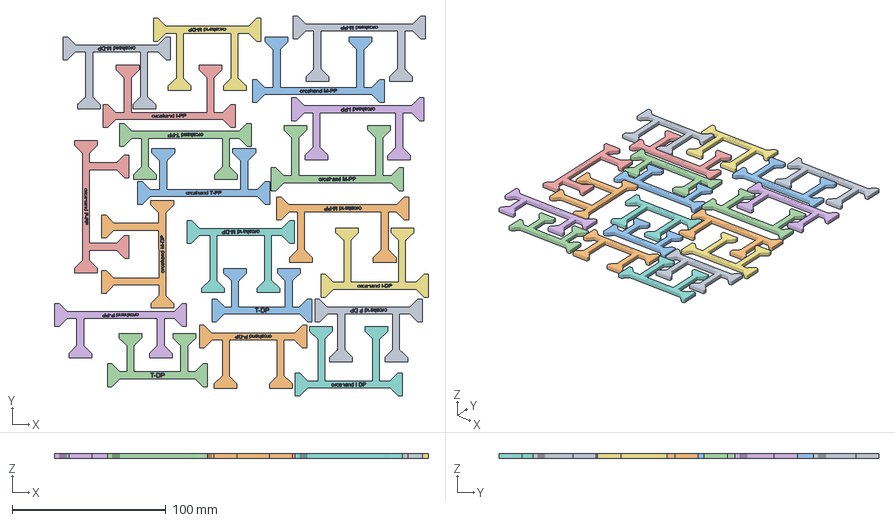
[picture p66: CAD file, 2026-10-17]
all files we corrently need/orca_v2/base_basic v2 version start with this folder/full v2 hand files/07_Molds/Clips-Only.3mf
243.2 x 246.9 x 3.50 mm
PP-SkinMold_M-PP-SkinMold_Clip.stl x 4
PP-SkinMold_I-PP-SkinMold_Clip.stl x 2
DP-SkinMold_M-DP-SkinMold_Clip.stl x 4
PP-SkinMold_T-PP-Skinmold_Clip.stl x 2
PP-SkinMold_P-PP-SkinMold_Clip.stl x 2
DP-SkinMold_I-DP-SkinMold_Clip.stl x 2
DP-SkinMold_P-DP-SkinMold_Clip.stl x 2
T-DP-Clip.stl x 2
