Thompson-Junyang/ucf-hand-design-project/all files we corrently need/orca_v2/base_basic v2 version start with this folder/full v2 hand files/09_Skin/Carpals_L-Carpals_Skin.stl

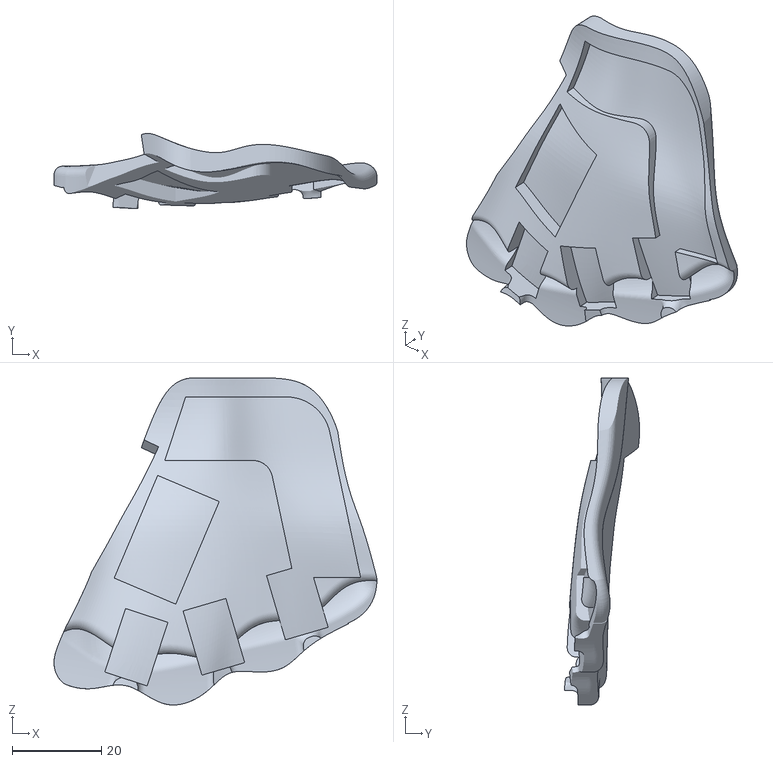
[picture p67: CAD file, 2026-10-17]
all files we corrently need/orca_v2/base_basic v2 version start with this folder/full v2 hand files/09_Skin/Carpals_L-Carpals_Skin.stl
72.4 x 16.8 x 73.3
