Thompson-Junyang/ucf-hand-design-project/all files we corrently need/orca_v2/lite_a simple verson of v2 we dont need/PP_P-PP-Lite_PP.stl

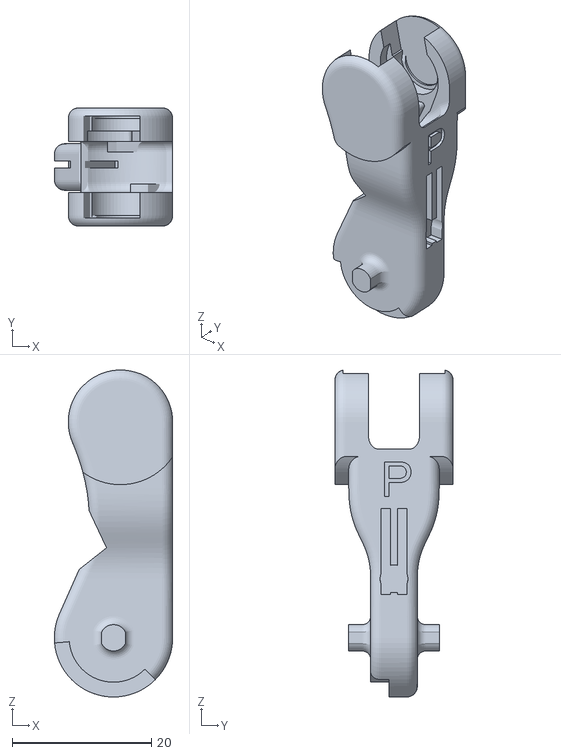
[picture p68: CAD file, 2026-10-17]
all files we corrently need/orca_v2/lite_a simple verson of v2 we dont need/PP_P-PP-Lite_PP.stl
17.0 x 17.0 x 47.0
