Thompson-Junyang/ucf-hand-design-project/full files check it out if have time/orca_v2/base/05_Spools/step_files/BaseSpool.step

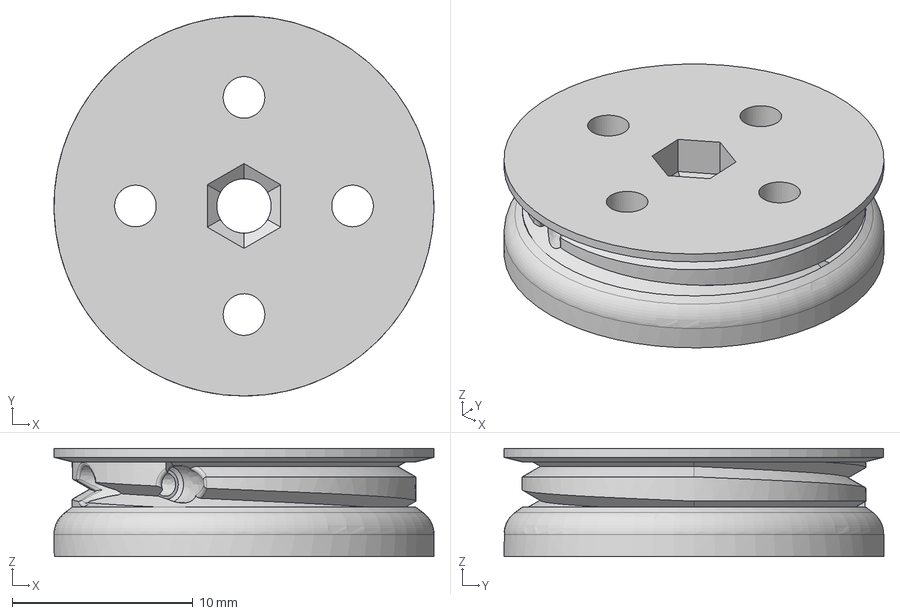
[picture p69: CAD file, 2026-10-17]
full files check it out if have time/orca_v2/base/05_Spools/step_files/BaseSpool.step
21.0 x 21.0 x 5.99 mm
