Thompson-Junyang/ucf-hand-design-project/full files check it out if have time/orca_v2/base/07_Molds/PP-SkinMold_M-PP-SkinMold_BottomMold.stl

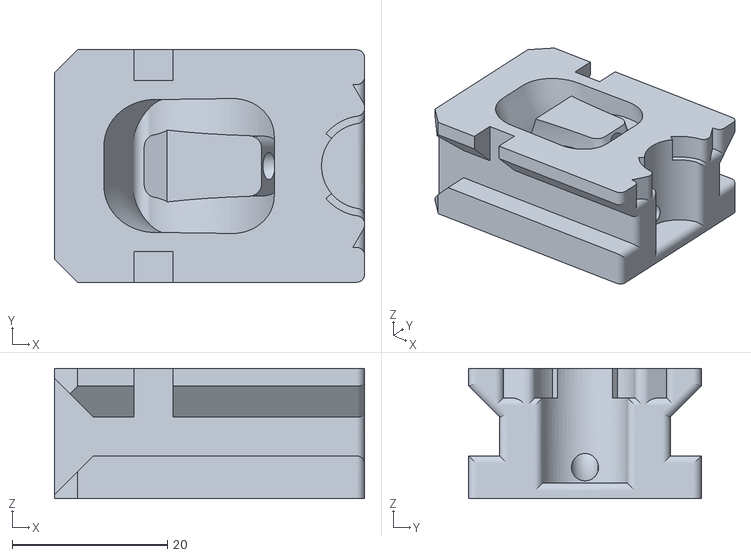
[picture p70: CAD file, 2026-10-17]
full files check it out if have time/orca_v2/base/07_Molds/PP-SkinMold_M-PP-SkinMold_BottomMold.stl
40.0 x 30.0 x 16.8
