Thompson-Junyang/ucf-hand-design-project/full files check it out if have time/orca_v2/base/09_Skin/DP-Skin_P-DP-Skin_Skin.stl

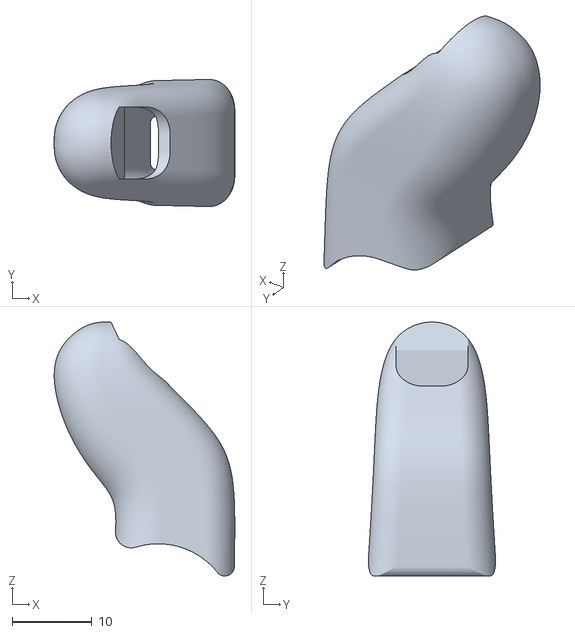
[picture p71: CAD file, 2026-10-17]
full files check it out if have time/orca_v2/base/09_Skin/DP-Skin_P-DP-Skin_Skin.stl
22.7 x 16.0 x 31.9
