Thompson-Junyang/ucf-hand-design-project/full files check it out if have time/orca_v2/lite/Carpals_R-Carpals-Lite_Carpals-Right.stl

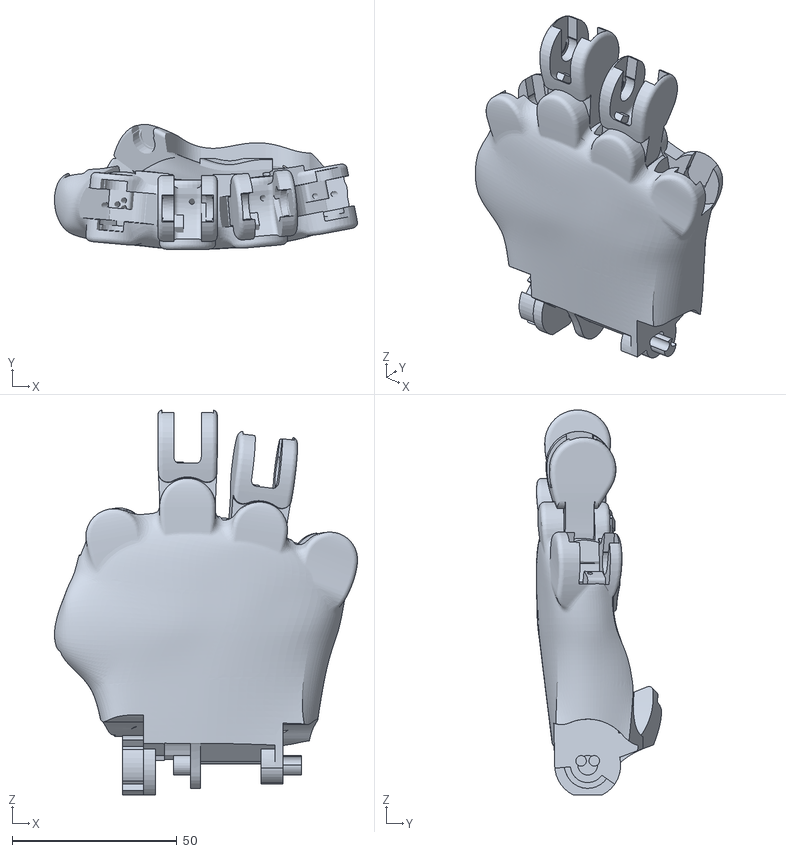
[picture p72: CAD file, 2026-10-17]
full files check it out if have time/orca_v2/lite/Carpals_R-Carpals-Lite_Carpals-Right.stl
91.9 x 38.0 x 116.7
