Thompson-Junyang/ucf-hand-design-project/full files check it out if have time/orca_v2/touch/01_Fingers/M-AP-Touch.stl

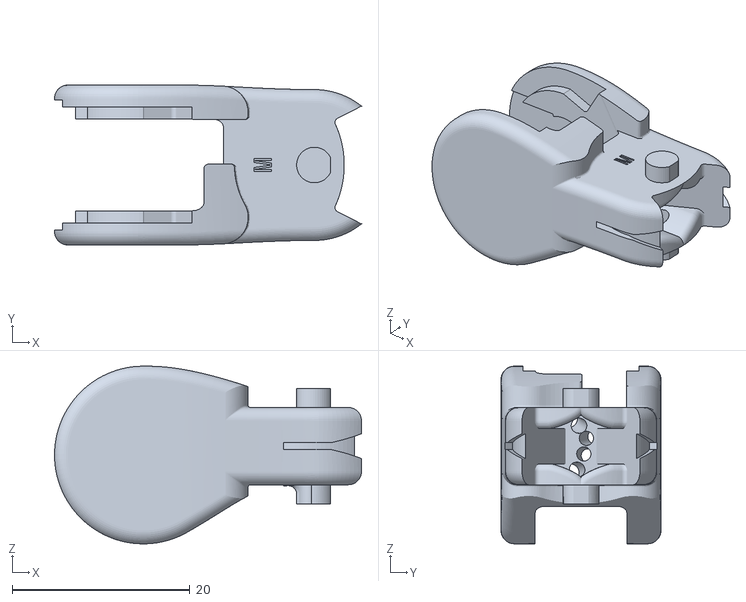
[picture p73: CAD file, 2026-10-17]
full files check it out if have time/orca_v2/touch/01_Fingers/M-AP-Touch.stl
34.6 x 18.0 x 20.0
