Thompson-Junyang/ucf-hand-design-project/all files we corrently need/orca_v2/base_basic v2 version start with this folder/full v2 hand files/04_ForeArm/SidePlate.step

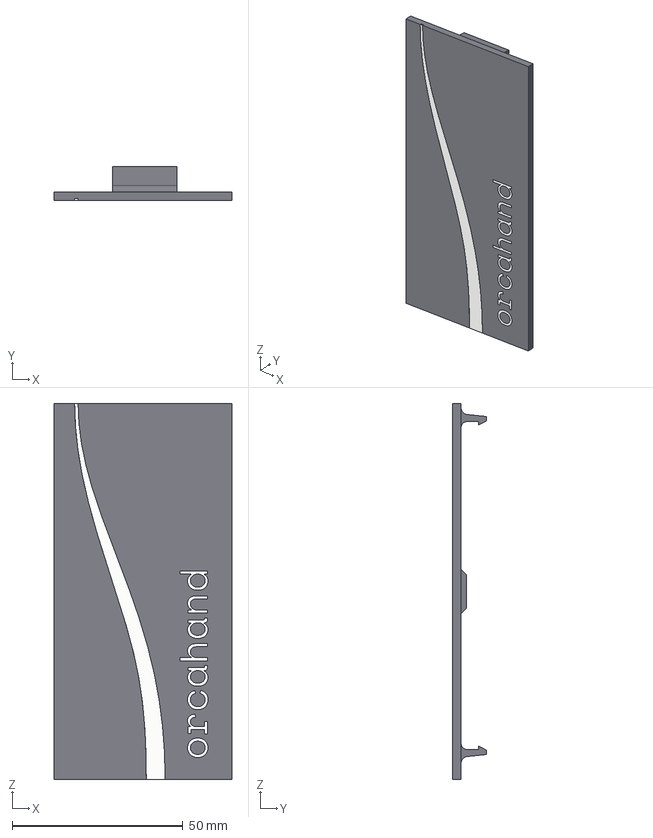
[picture p74: CAD file, 2026-10-17]
all files we corrently need/orca_v2/base_basic v2 version start with this folder/full v2 hand files/04_ForeArm/SidePlate.step
52.0 x 9.90 x 110.1 mm
