Thompson-Junyang/ucf-hand-design-project/all files we corrently need/orca_v2/base_basic v2 version start with this folder/full v2 hand files/07_Molds/PP-SkinMold_T-PP-Skinmold_Clip.stl

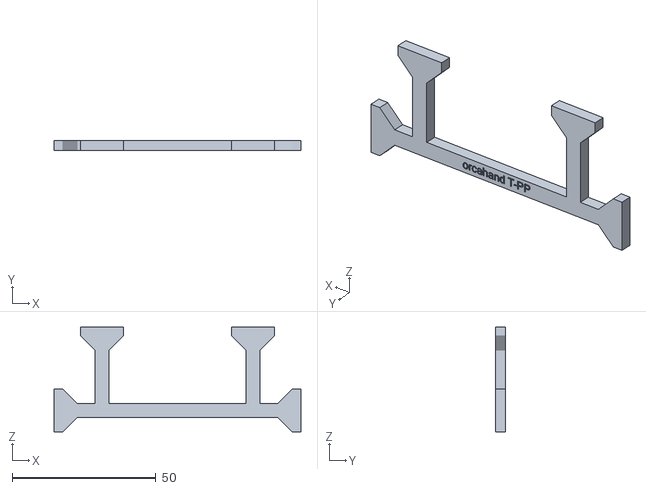
[picture p76: CAD file, 2026-10-17]
all files we corrently need/orca_v2/base_basic v2 version start with this folder/full v2 hand files/07_Molds/PP-SkinMold_T-PP-Skinmold_Clip.stl
86.0 x 3.50 x 36.5
