Thompson-Junyang/ucf-hand-design-project/all files we corrently need/orca_v2/base_basic v2 version start with this folder/full v2 hand files/09_Skin/DP-Skin_M-DP-Skin_Skin.stl

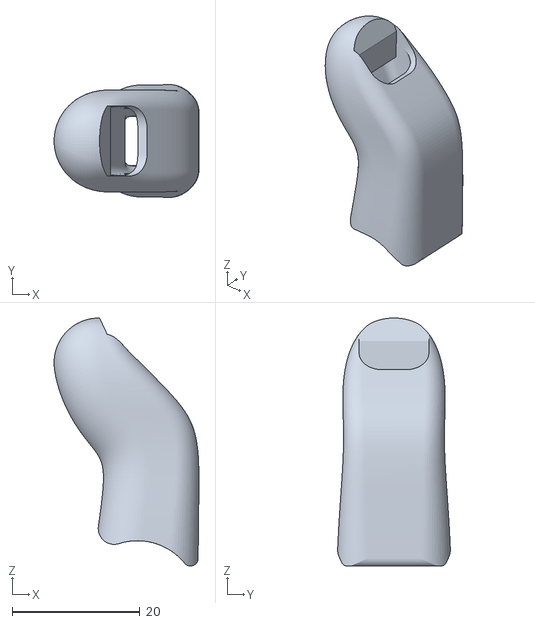
[picture p77: CAD file, 2026-10-17]
all files we corrently need/orca_v2/base_basic v2 version start with this folder/full v2 hand files/09_Skin/DP-Skin_M-DP-Skin_Skin.stl
22.7 x 17.7 x 38.9
