Thompson-Junyang/ucf-hand-design-project/all files we corrently need/orca_v2/lite_a simple verson of v2 we dont need/BaseSpool-Lite_Big_BaseSpool.stl

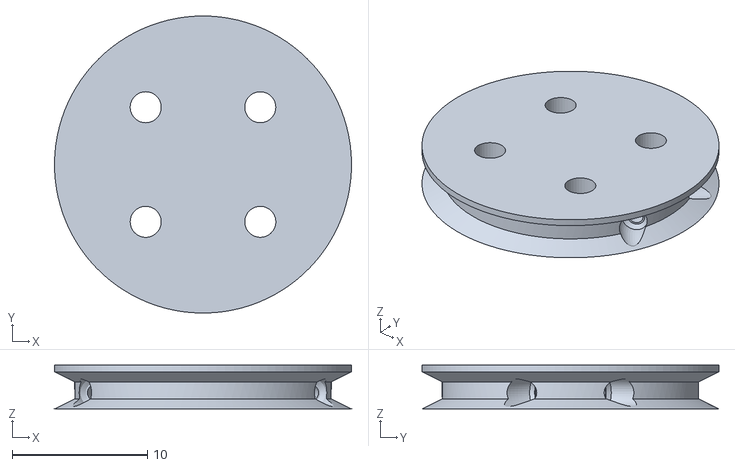
[picture p78: CAD file, 2026-10-17]
all files we corrently need/orca_v2/lite_a simple verson of v2 we dont need/BaseSpool-Lite_Big_BaseSpool.stl
22.0 x 22.0 x 3.25
