Thompson-Junyang/ucf-hand-design-project/all files we corrently need/orca_v2/touch_the version that allows us to add touch sensor/01_Fingers/M-IP-Touch.stl

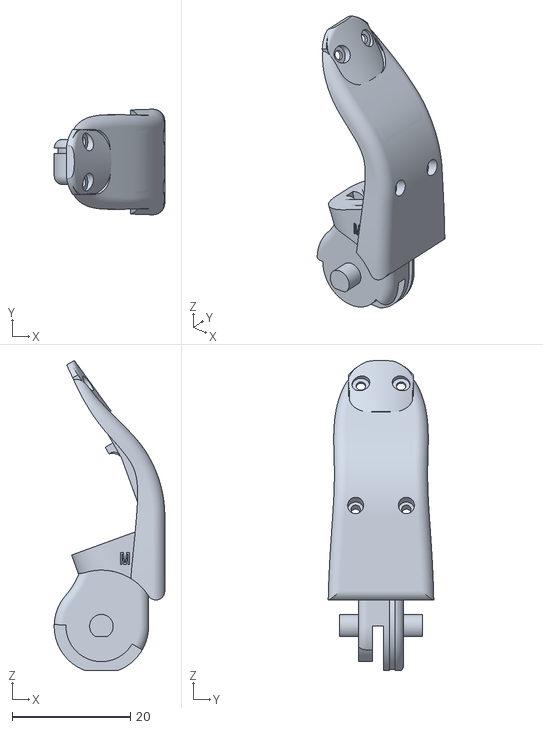
[picture p79: CAD file, 2026-10-17]
all files we corrently need/orca_v2/touch_the version that allows us to add touch sensor/01_Fingers/M-IP-Touch.stl
18.7 x 17.9 x 52.5
