Thompson-Junyang/ucf-hand-design-project/all files we corrently need/orca_v2/touch_the version that allows us to add touch sensor/01_Fingers/step_files/L-T-AP-Touch.step

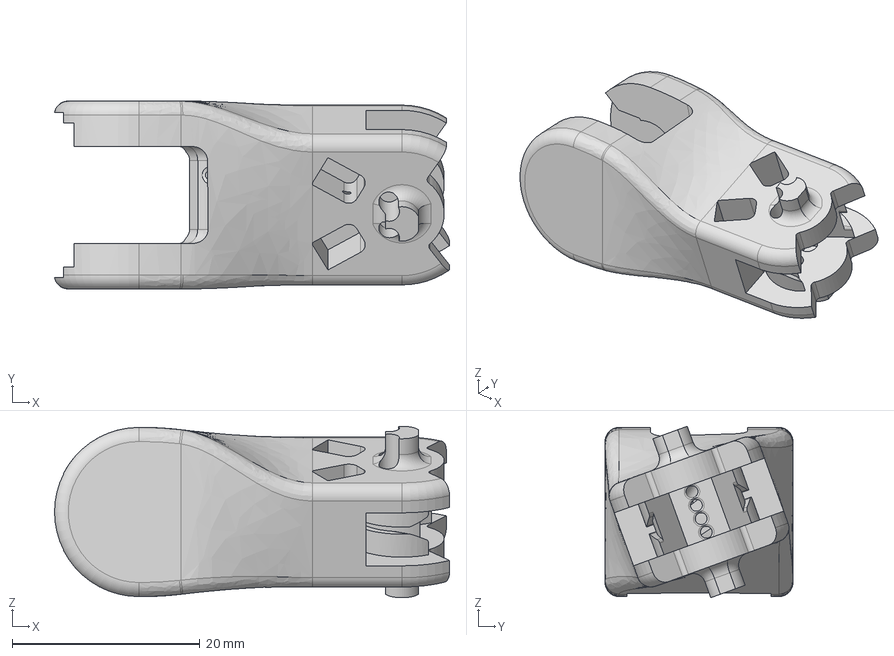
[picture p80: CAD file, 2026-10-17]
all files we corrently need/orca_v2/touch_the version that allows us to add touch sensor/01_Fingers/step_files/L-T-AP-Touch.step
42.0 x 20.0 x 18.2 mm
