Thompson-Junyang/ucf-hand-design-project/full files check it out if have time/orca_v2/base/04_ForeArm/U2D2-Holder.stl

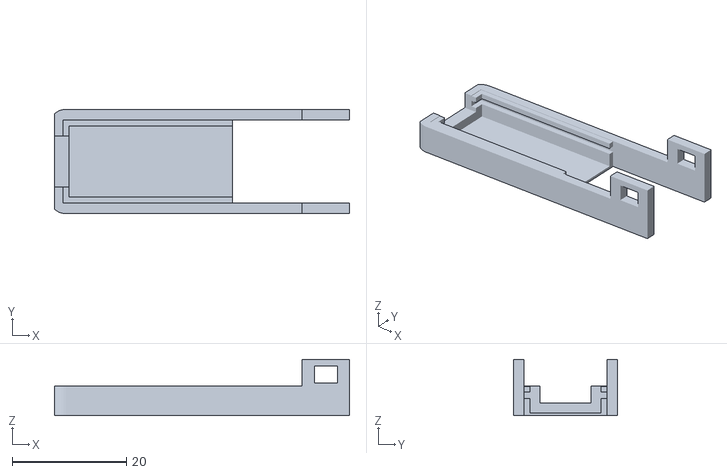
[picture p81: CAD file, 2026-10-17]
full files check it out if have time/orca_v2/base/04_ForeArm/U2D2-Holder.stl
51.6 x 18.2 x 9.84
