Thompson-Junyang/ucf-hand-design-project/full files check it out if have time/orca_v2/base/07_Molds/L-CarpalsMold-Compression.stl

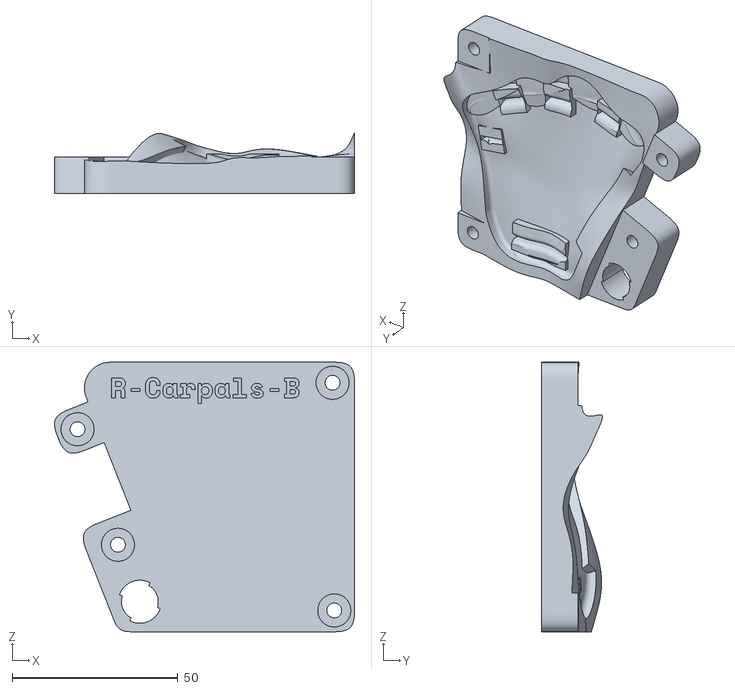
[picture p82: CAD file, 2026-10-17]
full files check it out if have time/orca_v2/base/07_Molds/L-CarpalsMold-Compression.stl
90.6 x 18.4 x 81.4
