Thompson-Junyang/ucf-hand-design-project/full files check it out if have time/orca_v2/lite/AP_I-AP-Lite-R_AP.stl

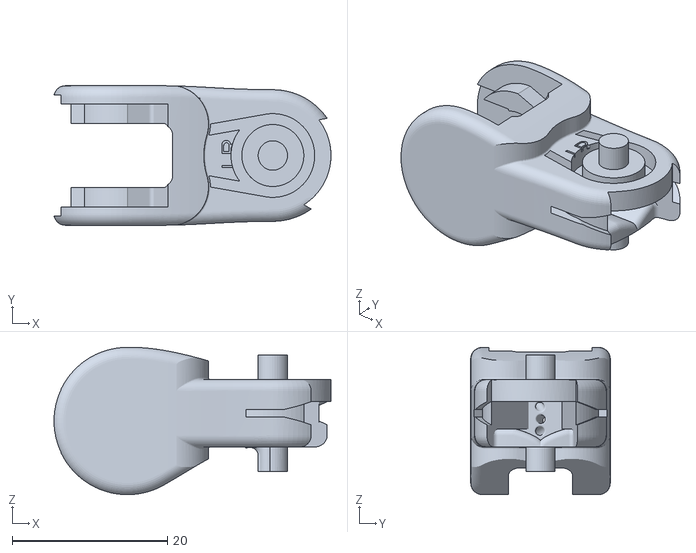
[picture p83: CAD file, 2026-10-17]
full files check it out if have time/orca_v2/lite/AP_I-AP-Lite-R_AP.stl
35.7 x 18.0 x 19.0
