Thompson-Junyang/ucf-hand-design-project/all files we corrently need/orca_v2/base_basic v2 version start with this folder/full v2 hand files/07_Molds/L-CarpalsMold-B-Funnel.stl

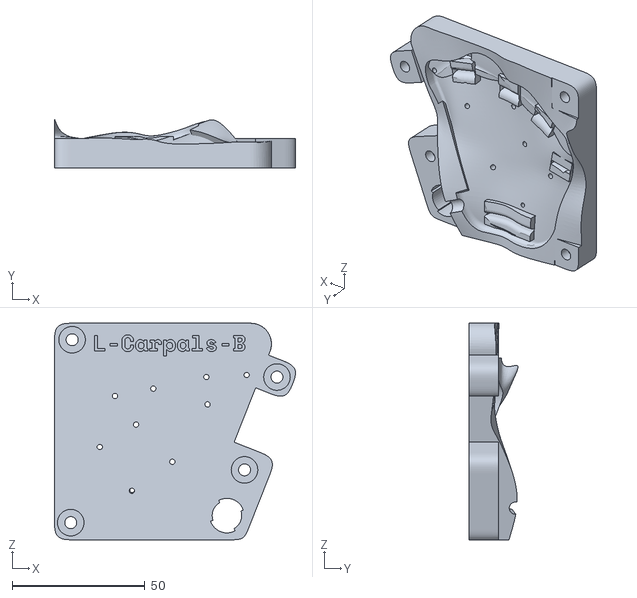
[picture p84: CAD file, 2026-10-17]
all files we corrently need/orca_v2/base_basic v2 version start with this folder/full v2 hand files/07_Molds/L-CarpalsMold-B-Funnel.stl
90.6 x 18.4 x 81.4
