Thompson-Junyang/ucf-hand-design-project/all files we corrently need/orca_v2/base_basic v2 version start with this folder/full v2 hand files/09_Skin/T-DP_Skin.stl

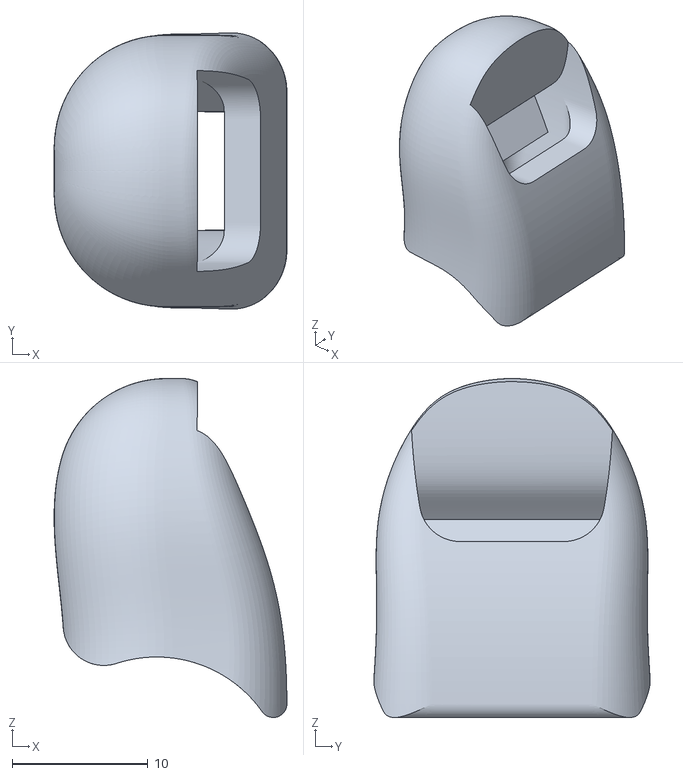
[picture p85: CAD file, 2026-10-17]
all files we corrently need/orca_v2/base_basic v2 version start with this folder/full v2 hand files/09_Skin/T-DP_Skin.stl
17.1 x 20.3 x 25.0
