Thompson-Junyang/ucf-hand-design-project/all files we corrently need/orca_v2/lite_a simple verson of v2 we dont need/Big.step

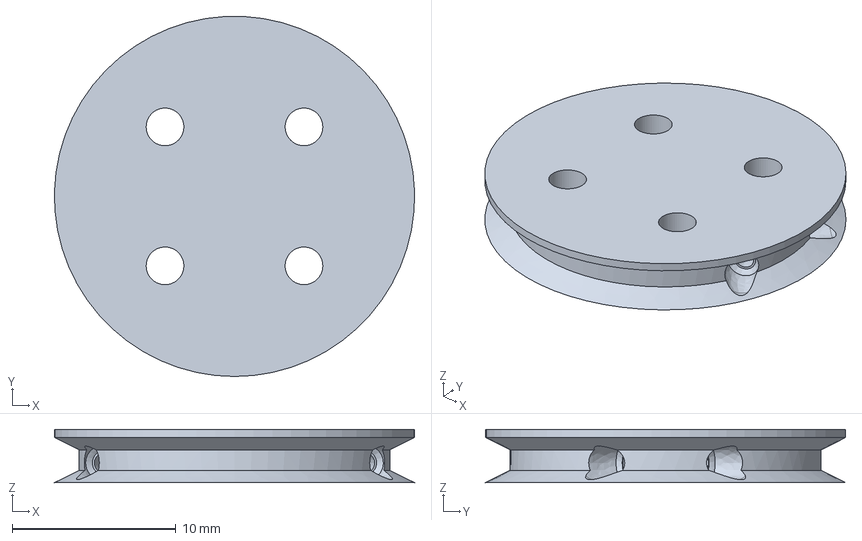
[picture p86: CAD file, 2026-10-17]
all files we corrently need/orca_v2/lite_a simple verson of v2 we dont need/Big.step
22.0 x 22.0 x 3.25 mm
