Thompson-Junyang/ucf-hand-design-project/full files check it out if have time/orca_v2/base/04_ForeArm/U2D2-Holder-B.stl

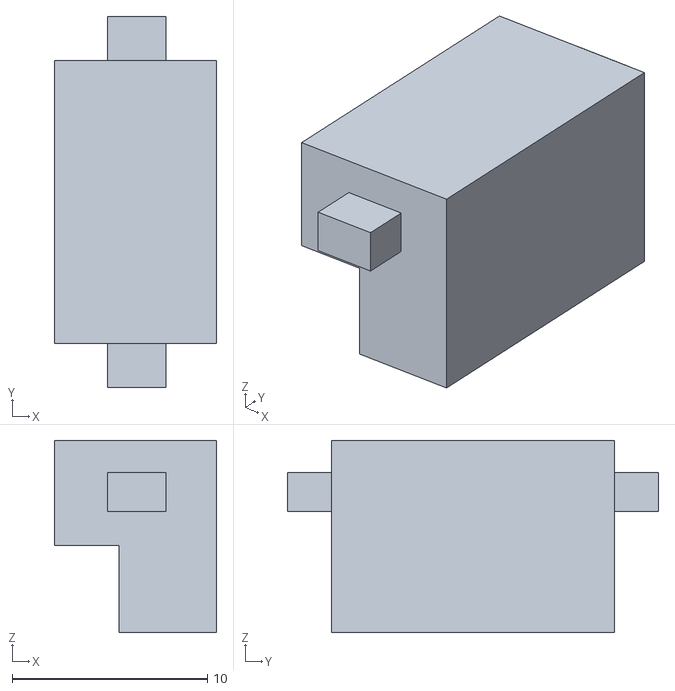
[picture p88: CAD file, 2026-10-17]
full files check it out if have time/orca_v2/base/04_ForeArm/U2D2-Holder-B.stl
8.30 x 19.0 x 9.84
