Thompson-Junyang/ucf-hand-design-project/full files check it out if have time/orca_v2/lite/WristTeeth-Lite_Small_Lite-WristSpool.stl

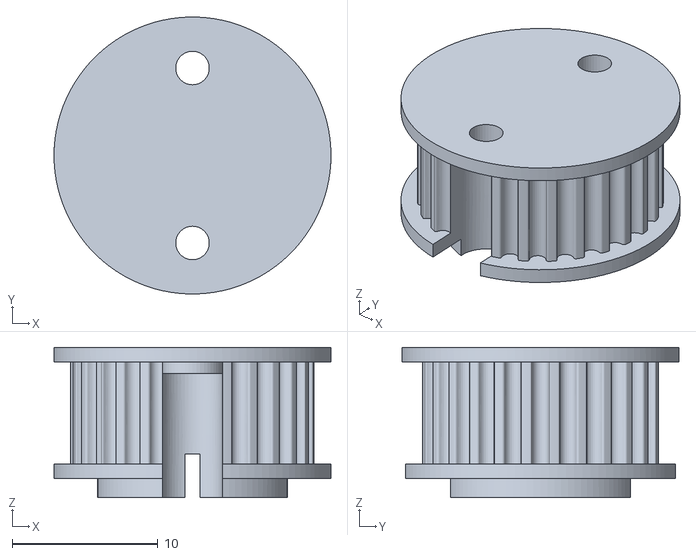
[picture p90: CAD file, 2026-10-17]
full files check it out if have time/orca_v2/lite/WristTeeth-Lite_Small_Lite-WristSpool.stl
19.0 x 19.0 x 10.3
