Thompson-Junyang/ucf-hand-design-project/full files check it out if have time/orca_v2/touch/01_Fingers/I-PP-Touch.stl

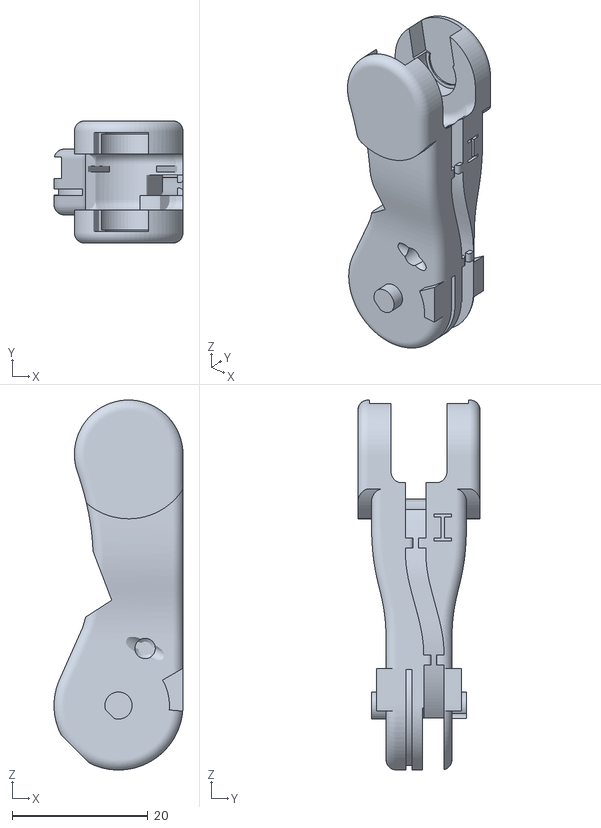
[picture p91: CAD file, 2026-10-17]
full files check it out if have time/orca_v2/touch/01_Fingers/I-PP-Touch.stl
19.0 x 18.0 x 54.5
