Thompson-Junyang/ucf-hand-design-project/all files we corrently need/orca_v2/base_basic v2 version start with this folder/full v2 hand files/07_Molds/M-DP-SkinMold_BottomMold.stl

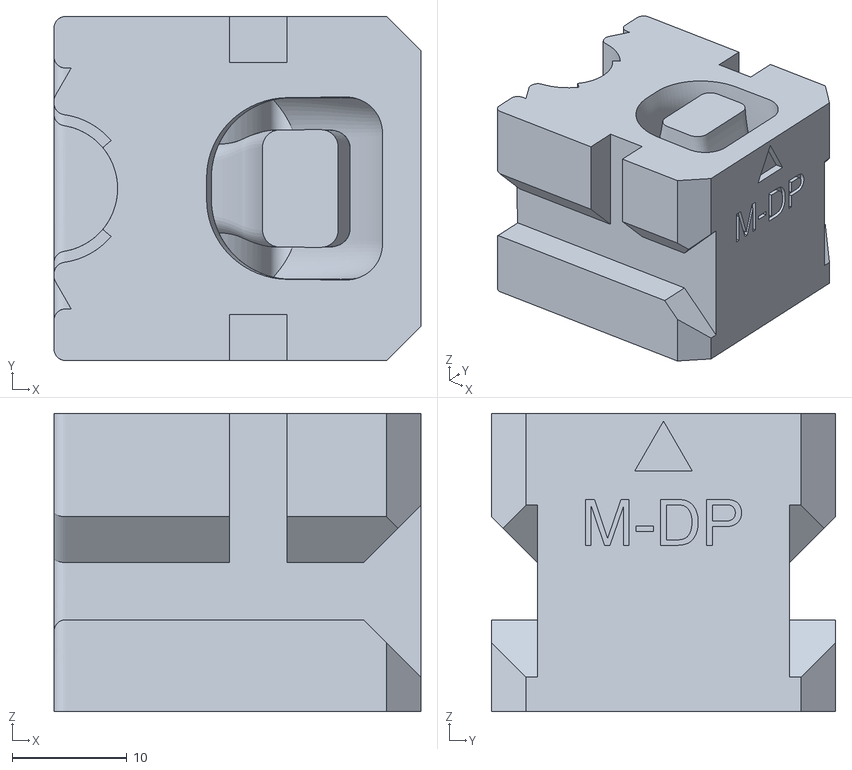
[picture p92: CAD file, 2026-10-17]
all files we corrently need/orca_v2/base_basic v2 version start with this folder/full v2 hand files/07_Molds/M-DP-SkinMold_BottomMold.stl
32.0 x 30.0 x 26.0
