Thompson-Junyang/ucf-hand-design-project/all files we corrently need/orca_v2/lite_a simple verson of v2 we dont need/I-IP-Lite.step

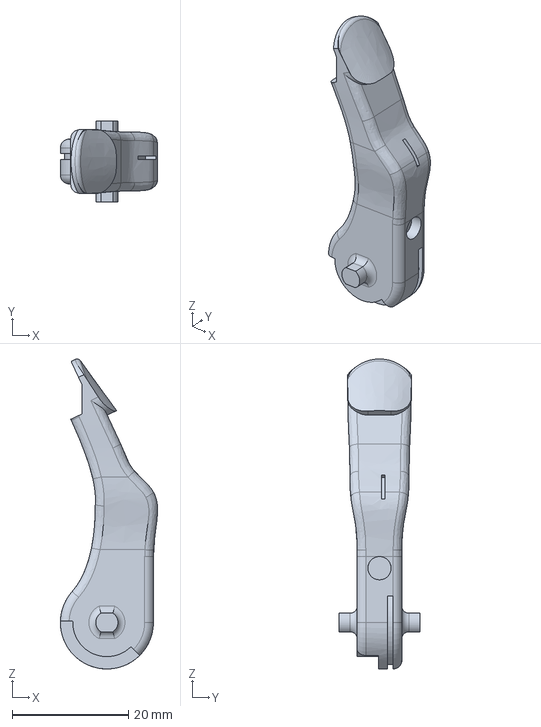
[picture p93: CAD file, 2026-10-17]
all files we corrently need/orca_v2/lite_a simple verson of v2 we dont need/I-IP-Lite.step
16.7 x 14.0 x 53.3 mm
