Thompson-Junyang/ucf-hand-design-project/(list of files, cad)

Other CAD files:
all files we corrently need/orca_v2/base_basic v2 version start with this folder/full v2 hand files/04_ForeArm/step_files/FanCover_TwoFans.step
full files check it out if have time/orca_v2/lite/M-IP-Lite.step
full files check it out if have time/orca_v2/touch/01_Fingers/step_files/T-TP-R-Touch.step
all files we corrently need/orca_v2/base_basic v2 version start with this folder/full v2 hand files/02_Carpals/step_files/L-Carpals.step
all files we corrently need/orca_v2/base_basic v2 version start with this folder/full v2 hand files/03_Wrist/step_files/WristStructure_Feetech.step
all files we corrently need/orca_v2/base_basic v2 version start with this folder/full v2 hand files/04_ForeArm/FanCover_Feetech 15.20.33.stl
all files we corrently need/orca_v2/touch_the version that allows us to add touch sensor/01_Fingers/step_files/T-TP-R-Touch.step
all files we corrently need/orca_v2/touch_the version that allows us to add touch sensor/Prints-2100.3mf
full files check it out if have time/orca_v2/touch/Prints-2100.3mf
all files we corrently need/orca_v2/base_basic v2 version start with this folder/full v2 hand files/02_Carpals/L-Carpals_Skin_TPU.stl
all files we corrently need/orca_v2/touch_the version that allows us to add touch sensor/01_Fingers/I-AP-L-Touch.stl
all files we corrently need/orca_v2/touch_the version that allows us to add touch sensor/02_Carpals/step_files/Carpals-R-Touch.step
full files check it out if have time/orca_v2/base/01_Fingers/step_files/I-AP-R.step
full files check it out if have time/orca_v2/base/02_Carpals/L-Carpals_Skin_TPU.stl
full files check it out if have time/orca_v2/base/02_Carpals/step_files/L-Carpals.step
full files check it out if have time/orca_v2/base/04_ForeArm/FanCover_Feetech 15.20.33.stl
full files check it out if have time/orca_v2/base/04_ForeArm/step_files/ForeArmStructure_Feetech.step
full files check it out if have time/orca_v2/touch/02_Carpals/step_files/Carpals-R-Touch.step
all files we corrently need/orca_v2/base_basic v2 version start with this folder/full v2 hand files/02_Carpals/CORE-L.stl
all files we corrently need/orca_v2/touch_the version that allows us to add touch sensor/02_Carpals/step_files/Coav-R.step
full files check it out if have time/orca_v2/base/01_Fingers/step_files/I-AP-L.step
full files check it out if have time/orca_v2/base/02_Carpals/Coav-L.stl
full files check it out if have time/orca_v2/base/03_Wrist/step_files/WristStructure_Feetech.step
full files check it out if have time/orca_v2/base/04_ForeArm/step_files/FanCover_TwoFans.step
full files check it out if have time/orca_v2/touch/01_Fingers/I-AP-L-Touch.stl
full files check it out if have time/orca_v2/touch/02_Carpals/step_files/Coav-R.step
all files we corrently need/orca_v2/base_basic v2 version start with this folder/full v2 hand files/01_Fingers/step_files/M-IP.step
all files we corrently need/orca_v2/base_basic v2 version start with this folder/full v2 hand files/02_Carpals/Coav-L.stl
all files we corrently need/orca_v2/base_basic v2 version start with this folder/full v2 hand files/03_Wrist/step_files/WristAdapter_Dynamixel.step
all files we corrently need/orca_v2/base_basic v2 version start with this folder/full v2 hand files/04_ForeArm/step_files/ForeArmStructure_Feetech.step
full files check it out if have time/orca_v2/base/03_Wrist/step_files/WristAdapter_Dynamixel.step
all files we corrently need/orca_v2/base_basic v2 version start with this folder/full v2 hand files/01_Fingers/step_files/T-TP-R.step
all files we corrently need/orca_v2/base_basic v2 version start with this folder/full v2 hand files/04_ForeArm/SpoolHolder.stl
all files we corrently need/orca_v2/base_basic v2 version start with this folder/full v2 hand files/09_Skin/Carpals_R-Carpals_Skin.stl
full files check it out if have time/orca_v2/base/01_Fingers/step_files/M-IP.step
full files check it out if have time/orca_v2/base/02_Carpals/CORE-L.stl
full files check it out if have time/orca_v2/base/04_ForeArm/FanCover_U2D2.stl
all files we corrently need/orca_v2/base_basic v2 version start with this folder/full v2 hand files/01_Fingers/I-AP-L.stl
all files we corrently need/orca_v2/base_basic v2 version start with this folder/full v2 hand files/01_Fingers/I-AP-R.stl
all files we corrently need/orca_v2/base_basic v2 version start with this folder/full v2 hand files/01_Fingers/I-IP.stl
all files we corrently need/orca_v2/base_basic v2 version start with this folder/full v2 hand files/01_Fingers/I-PP.stl
all files we corrently need/orca_v2/base_basic v2 version start with this folder/full v2 hand files/01_Fingers/L-T-AP.stl
all files we corrently need/orca_v2/base_basic v2 version start with this folder/full v2 hand files/01_Fingers/M-AP.stl
all files we corrently need/orca_v2/base_basic v2 version start with this folder/full v2 hand files/01_Fingers/M-IP.stl
all files we corrently need/orca_v2/base_basic v2 version start with this folder/full v2 hand files/01_Fingers/M-PP.stl
all files we corrently need/orca_v2/base_basic v2 version start with this folder/full v2 hand files/01_Fingers/P-AP.stl
all files we corrently need/orca_v2/base_basic v2 version start with this folder/full v2 hand files/01_Fingers/P-IP.stl
all files we corrently need/orca_v2/base_basic v2 version start with this folder/full v2 hand files/01_Fingers/P-PP.stl
all files we corrently need/orca_v2/base_basic v2 version start with this folder/full v2 hand files/01_Fingers/R-T-AP.stl
all files we corrently need/orca_v2/base_basic v2 version start with this folder/full v2 hand files/01_Fingers/T-PP.stl
all files we corrently need/orca_v2/base_basic v2 version start with this folder/full v2 hand files/01_Fingers/T-TP-L.stl
all files we corrently need/orca_v2/base_basic v2 version start with this folder/full v2 hand files/01_Fingers/T-TP-R.stl
all files we corrently need/orca_v2/base_basic v2 version start with this folder/full v2 hand files/01_Fingers/step_files/I-AP-L.step
all files we corrently need/orca_v2/base_basic v2 version start with this folder/full v2 hand files/01_Fingers/step_files/I-AP-R.step
all files we corrently need/orca_v2/base_basic v2 version start with this folder/full v2 hand files/01_Fingers/step_files/I-PP.step
all files we corrently need/orca_v2/base_basic v2 version start with this folder/full v2 hand files/01_Fingers/step_files/L-T-AP.step
all files we corrently need/orca_v2/base_basic v2 version start with this folder/full v2 hand files/01_Fingers/step_files/M-AP.step
all files we corrently need/orca_v2/base_basic v2 version start with this folder/full v2 hand files/01_Fingers/step_files/P-IP.step
all files we corrently need/orca_v2/base_basic v2 version start with this folder/full v2 hand files/01_Fingers/step_files/T-PP.step
all files we corrently need/orca_v2/base_basic v2 version start with this folder/full v2 hand files/01_Fingers/step_files/T-TP-L.step
all files we corrently need/orca_v2/base_basic v2 version start with this folder/full v2 hand files/02_Carpals/CarpalsTeeth.stl
all files we corrently need/orca_v2/base_basic v2 version start with this folder/full v2 hand files/02_Carpals/L-Carpals.stl
all files we corrently need/orca_v2/base_basic v2 version start with this folder/full v2 hand files/02_Carpals/R-Carpals.stl
all files we corrently need/orca_v2/base_basic v2 version start with this folder/full v2 hand files/03_Wrist/CableHolder-A.stl
all files we corrently need/orca_v2/base_basic v2 version start with this folder/full v2 hand files/03_Wrist/CableHolder-B.stl
all files we corrently need/orca_v2/base_basic v2 version start with this folder/full v2 hand files/03_Wrist/WristAdapter_Dynamixel.stl
all files we corrently need/orca_v2/base_basic v2 version start with this folder/full v2 hand files/03_Wrist/WristAdapter_Feetech.stl
all files we corrently need/orca_v2/base_basic v2 version start with this folder/full v2 hand files/03_Wrist/WristStructure_Dynamixel.stl
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
