Thompson-Junyang/ucf-hand-design-project/all files we corrently need/orca_v2/electronics_pcb files and random/ORCA_Motor_Connectors_Gerber/How-to-order-PCB.txt

How to Order PCB

Please refer to:
https://docs.easyeda.com/en/PCB/Order-PCB
