Thompson-Junyang/ucf-hand-design-project/(commit log)

2026-10-17 add bom organized by junyang
    [ORCA_Hand_V2_Complete_BOM_Organized_by_Junyang.xlsx]
2026-10-17 Revise BOM warning in README
    Updated warning regarding the use of the original BOM and README for purchasing components.
2026-10-17 Update BOM instructions and worksheet details
    Clarified BOM usage and organization details in the README.
2026-10-18 Revise README for clarity on 3D printing and molding
    Updated README to clarify silicone molding process and print profile stability.
2026-11-03 Update test code for motor
